Justin-Riekehof/zeroth-01-build/hardware/backpack_v2/viewer/viewer_template.html

X linksY hintenZ obenRoboter-Frame, mm

Z-Bot · Zeroth-01 · CAD-Pin 93de7567

# Pixel Backpack v2

Gesamter Roboter aus dem gepinnten OnShape-Stand mit dem neuen Elektronik-Rucksack. Ziehen dreht, Rad zoomt, rechte Taste verschiebt, Klick nennt das Teil.

## Ansicht

Iso Hinten Links Oben Vorn

## Teile

Roboter (Torso, Arme, Beine, Kopf)GLB Grundrahmen mit LiPo-SchubladeTeil 1 Elektronik-DeckTeil 2 RückdeckelTeil 3 Bauteil-Hüllen (LiPo, Pi, Cutoff …)Kontrolle Original-Backpack (K-Scale)105×24×80

Explosion0 mm Deckel-Deckkraft100 %

## Maße

Hüllkörper B × T × H

146 × 66,5 × 123 mm

Tiefe ab Rückwand (Y 38,1)

66,5 mm

Original K-Scale

105 × 24 × 80 mm

Höhe über Boden

Z 254 – 377

Breite

X ±73 (Torso)

Torso-Schrauben

4× M3, Ø4 Hülsen

Masse bestückt, geschätzt

≈ 750 g

Schwerpunkt hinter Rückwand

≈ 30 mm

Δ Schwerpunkt Roboter

+11 hinten · +10 oben

Arme schwingen laut Gelenkgrenzen nur nach vorn; Beine erreichen die Rückenzone unterhalb Z 252 erst ab Y 128. Details in hardware/backpack_v2/README.md.
