Justin-Riekehof/zeroth-01-build/hardware/backpack_v2/preview_iso.png

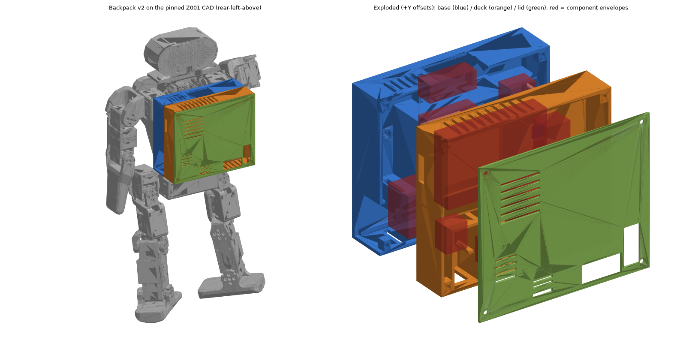
hardware/backpack_v2/preview_iso.png
