Justin-Riekehof/zeroth-01-build/media/whole-body-demo.gif

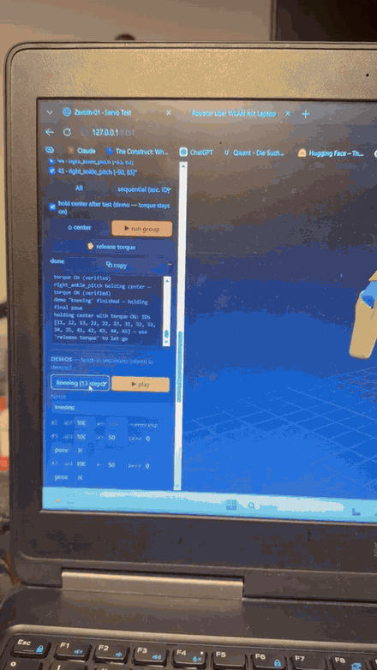
media/whole-body-demo.gif
