Justin-Riekehof/zeroth-01-build/hardware/backpack_v2/preview_v3_parts.png

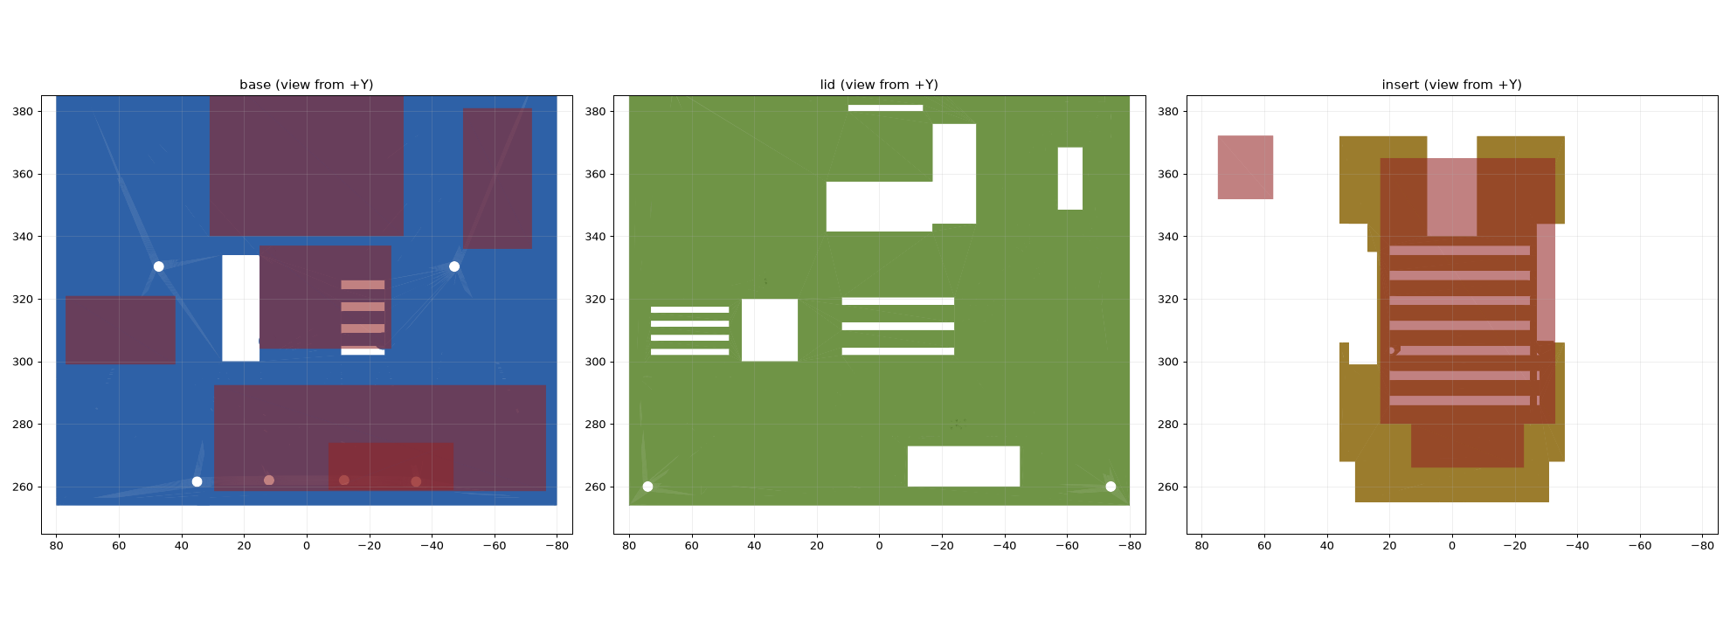
hardware/backpack_v2/preview_v3_parts.png
