Justin-Riekehof/zeroth-01-build/hardware/backpack_v2/print/pixel-backpack-v4_1-base.stl

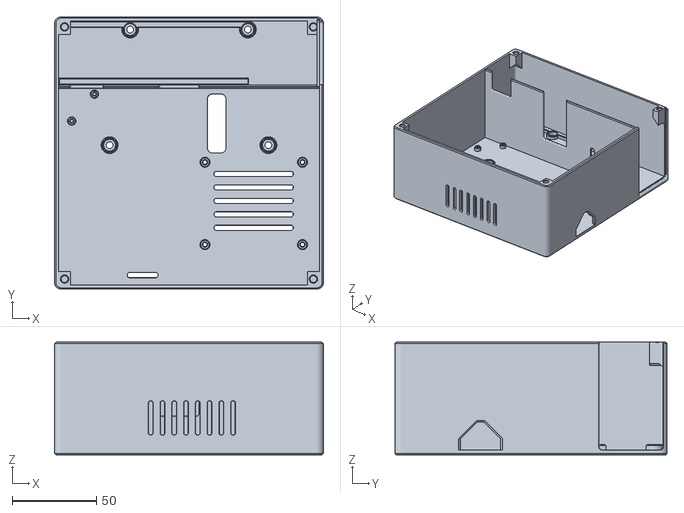
[picture p11: CAD file, 2026-10-01]
hardware/backpack_v2/print/pixel-backpack-v4_1-base.stl
160.0 x 162.0 x 67.0
