Justin-Riekehof/zeroth-01-build/hardware/backpack_v2/print/v3.1_scharfkantig/pixel-backpack-v3.1_1-base.stl

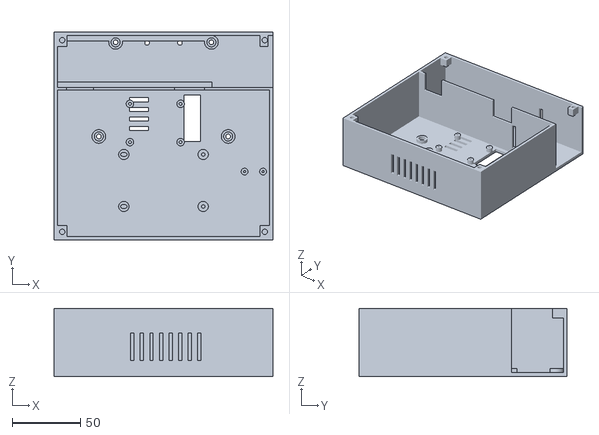
[picture p12: CAD file, 2026-09-22]
hardware/backpack_v2/print/v3.1_scharfkantig/pixel-backpack-v3.1_1-base.stl
160.0 x 152.0 x 50.0
