Justin-Riekehof/zeroth-01-build/hardware/backpack_v2/stl_v3/cables/pololu_5v_usbc.stl

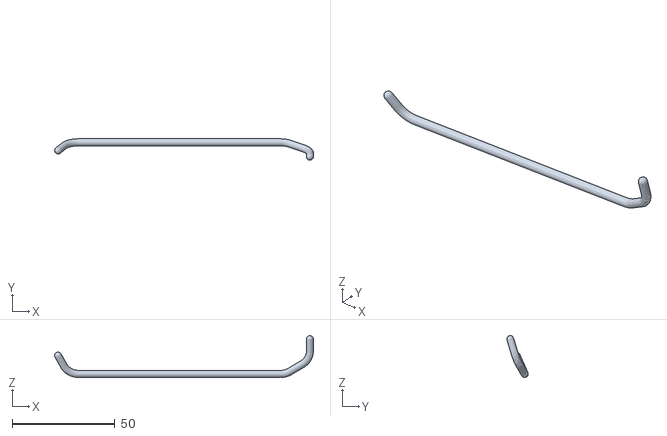
[picture p13: CAD file, 2026-10-01]
hardware/backpack_v2/stl_v3/cables/pololu_5v_usbc.stl
126.3 x 10.5 x 20.5
