Justin-Riekehof/zeroth-01-build/hardware/backpack_v2/stl_v3/placeholder_pi_plugs.stl

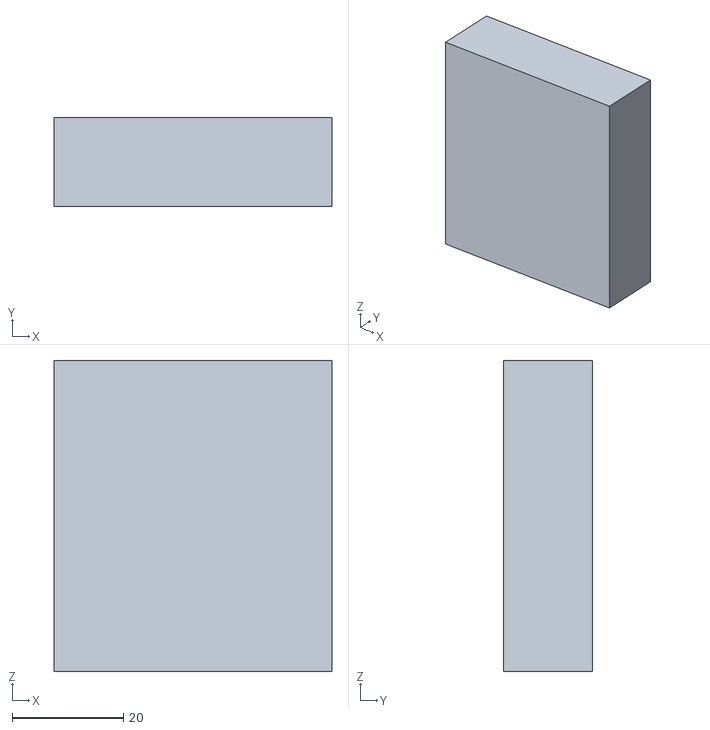
[picture p14: CAD file, 2026-10-01]
hardware/backpack_v2/stl_v3/placeholder_pi_plugs.stl
50.0 x 16.0 x 56.0
