Justin-Riekehof/zeroth-01-build/hardware/head_cam/print/head_shell_cam3.stl

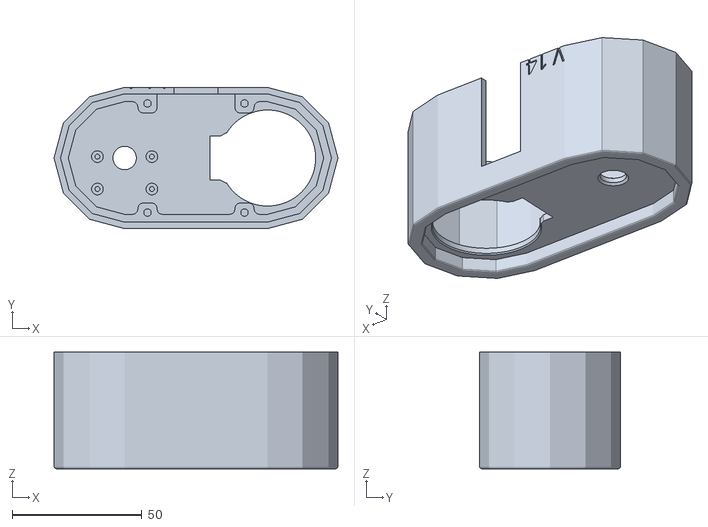
[picture p15: CAD file, 2026-09-22]
hardware/head_cam/print/head_shell_cam3.stl
109.5 x 54.5 x 45.0
