Justin-Riekehof/zeroth-01-build/hardware/head_cam/stl/robotframe/cam3_board.stl

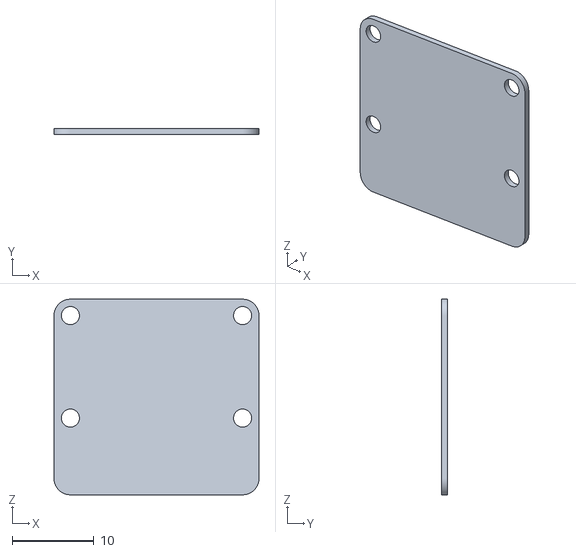
[picture p16: CAD file, 2026-09-22]
hardware/head_cam/stl/robotframe/cam3_board.stl
25.0 x 0.757 x 23.9
