Justin-Riekehof/zeroth-01-build/hardware/head_imu/print/neck_mount_imu.stl

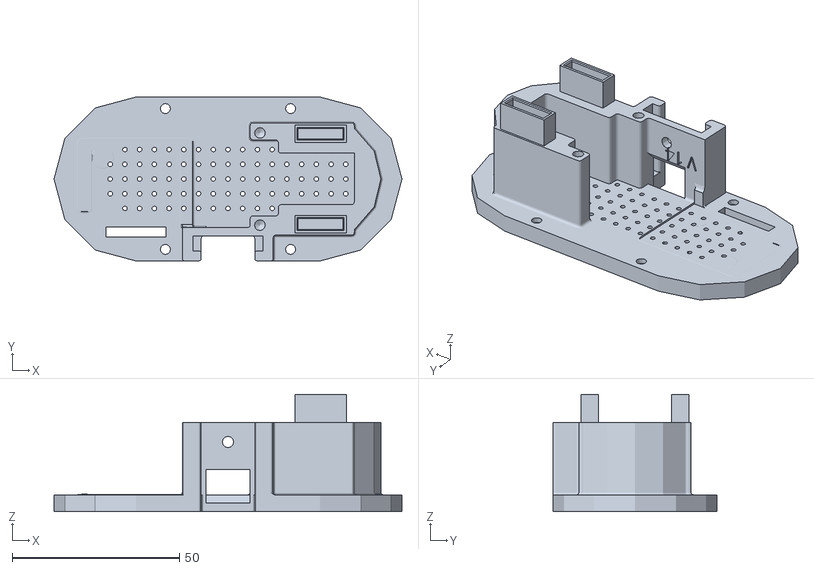
[picture p17: CAD file, 2026-10-01]
hardware/head_imu/print/neck_mount_imu.stl
104.0 x 49.0 x 35.0
