Justin-Riekehof/zeroth-01-build/hardware/head_imu/stl/imu_rp2040.stl

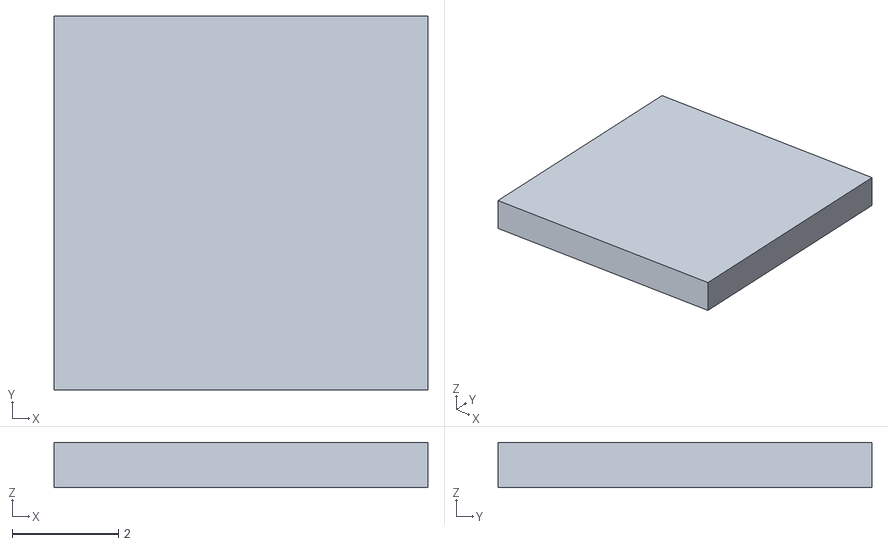
[picture p18: CAD file, 2026-09-22]
hardware/head_imu/stl/imu_rp2040.stl
7.04 x 7.04 x 0.85
