Justin-Riekehof/zeroth-01-build/sim/assets/zbot-cad/meshes/base_printed.stl

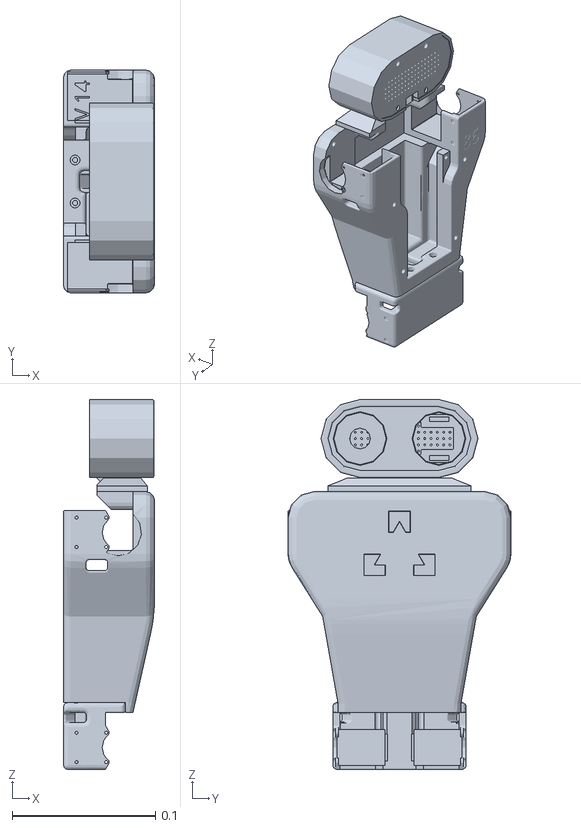
[picture p19: CAD file, 2026-09-26]
sim/assets/zbot-cad/meshes/base_printed.stl
0.0635 x 0.155 x 0.258
