Justin-Riekehof/zeroth-01-build/hardware/backpack_v2/print/pixel-backpack-v4_2-lid.stl

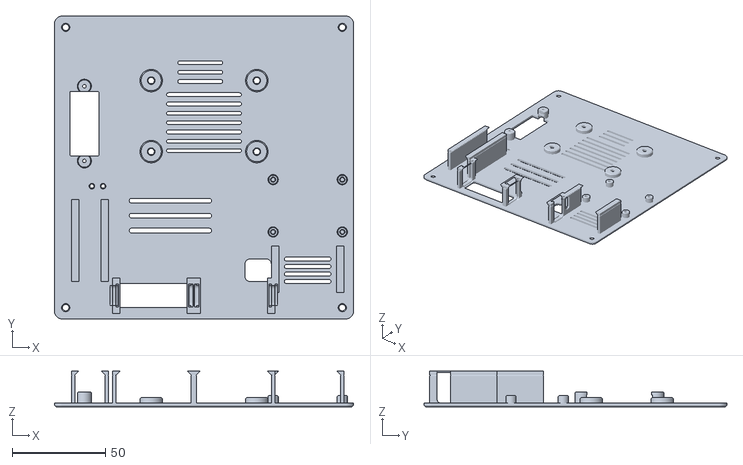
[picture p20: CAD file, 2026-10-01]
hardware/backpack_v2/print/pixel-backpack-v4_2-lid.stl
160.0 x 162.0 x 19.1
