Justin-Riekehof/zeroth-01-build/hardware/backpack_v2/print/v3.1_scharfkantig/pixel-backpack-v3.1_2-lid.stl

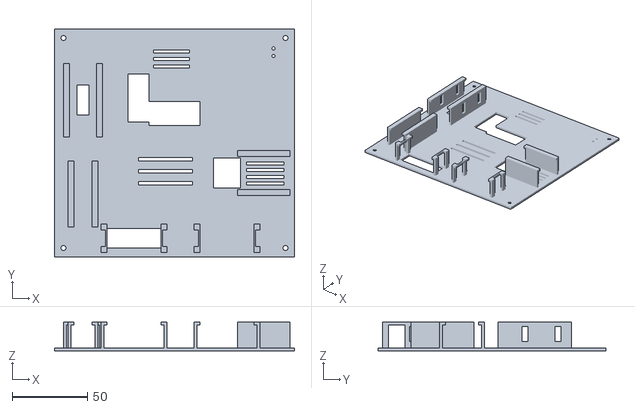
[picture p21: CAD file, 2026-09-22]
hardware/backpack_v2/print/v3.1_scharfkantig/pixel-backpack-v3.1_2-lid.stl
160.0 x 152.0 x 19.1
