Justin-Riekehof/zeroth-01-build/hardware/backpack_v2/stl_v3/cables/switch_out_pigtail.stl

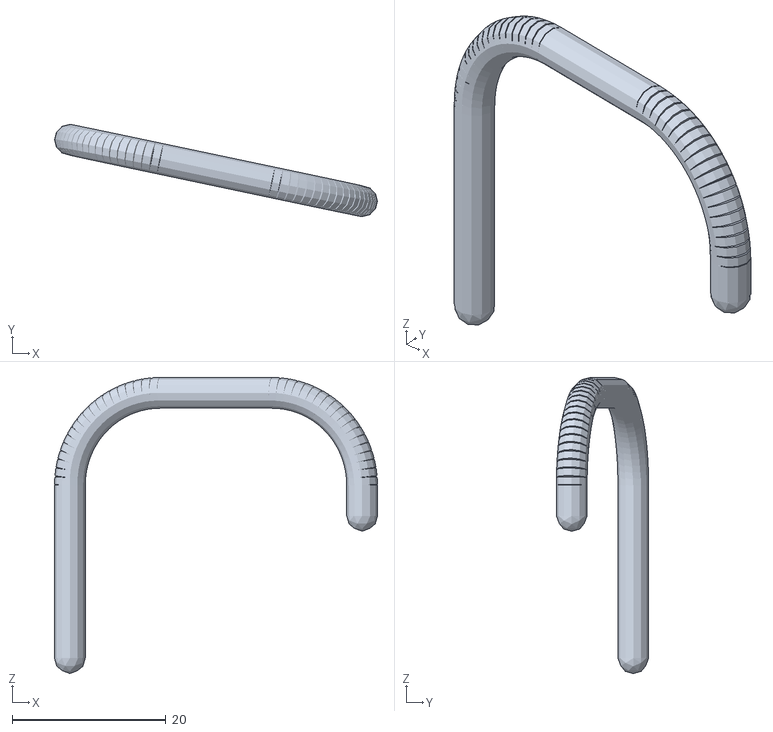
[picture p22: CAD file, 2026-10-01]
hardware/backpack_v2/stl_v3/cables/switch_out_pigtail.stl
42.0 x 12.0 x 38.5
