Justin-Riekehof/zeroth-01-build/hardware/backpack_v2/stl_v3/placeholder_pi_sd.stl

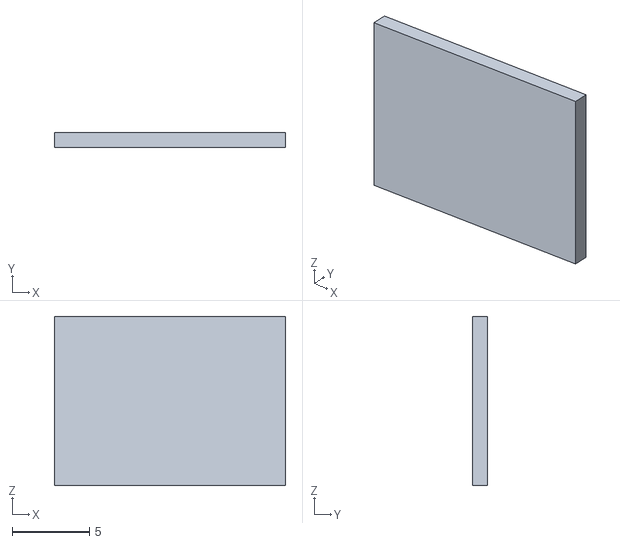
[picture p23: CAD file, 2026-10-01]
hardware/backpack_v2/stl_v3/placeholder_pi_sd.stl
15.0 x 1.00 x 11.0
