Justin-Riekehof/zeroth-01-build/hardware/head_imu/stl/imu_axis_x.stl

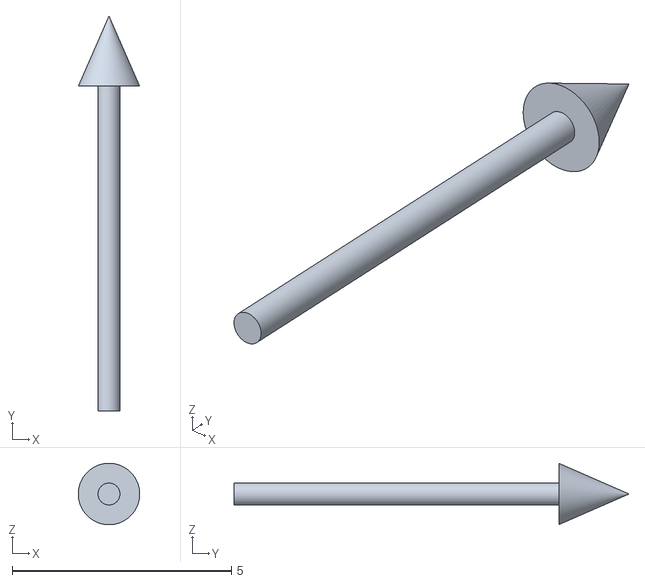
[picture p24: CAD file, 2026-09-22]
hardware/head_imu/stl/imu_axis_x.stl
1.40 x 9.00 x 1.40
