Justin-Riekehof/zeroth-01-build/sim/assets/zbot-cad/meshes/backpack_base.stl

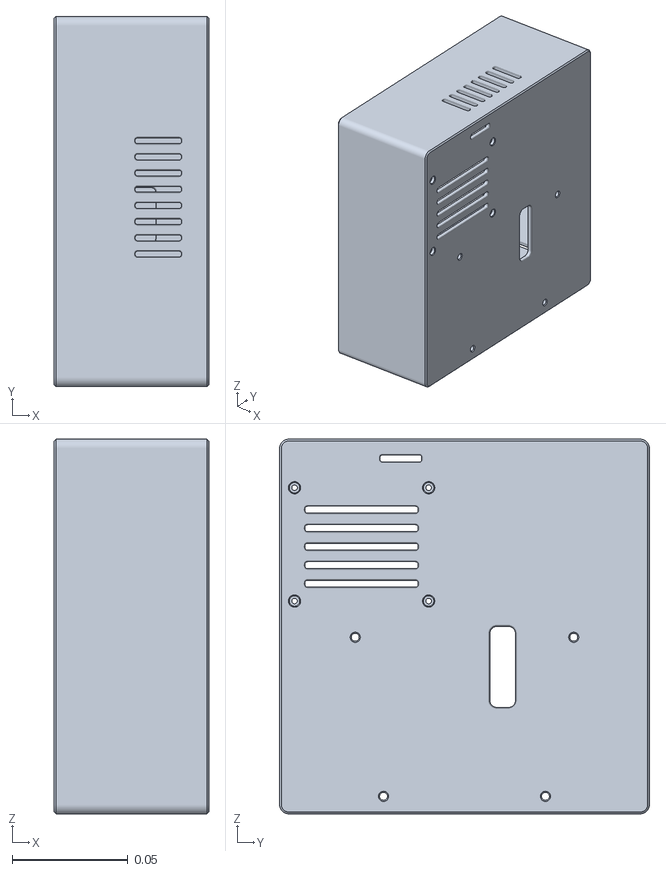
[picture p25: CAD file, 2026-09-26]
sim/assets/zbot-cad/meshes/backpack_base.stl
0.067 x 0.16 x 0.162
