Justin-Riekehof/zeroth-01-build/sim/assets/zbot-pixel-backpack/meshes/backpack_insert.stl

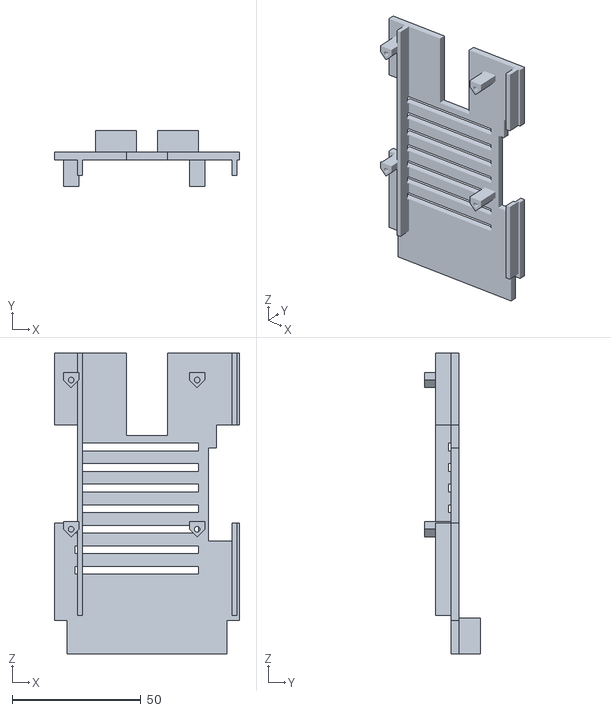
[picture p26: CAD file, 2026-09-22]
sim/assets/zbot-pixel-backpack/meshes/backpack_insert.stl
72.0 x 21.9 x 117.0
