Justin-Riekehof/zeroth-01-build/hardware/backpack_v2/stl_v3/cables/out_to_pololu.stl

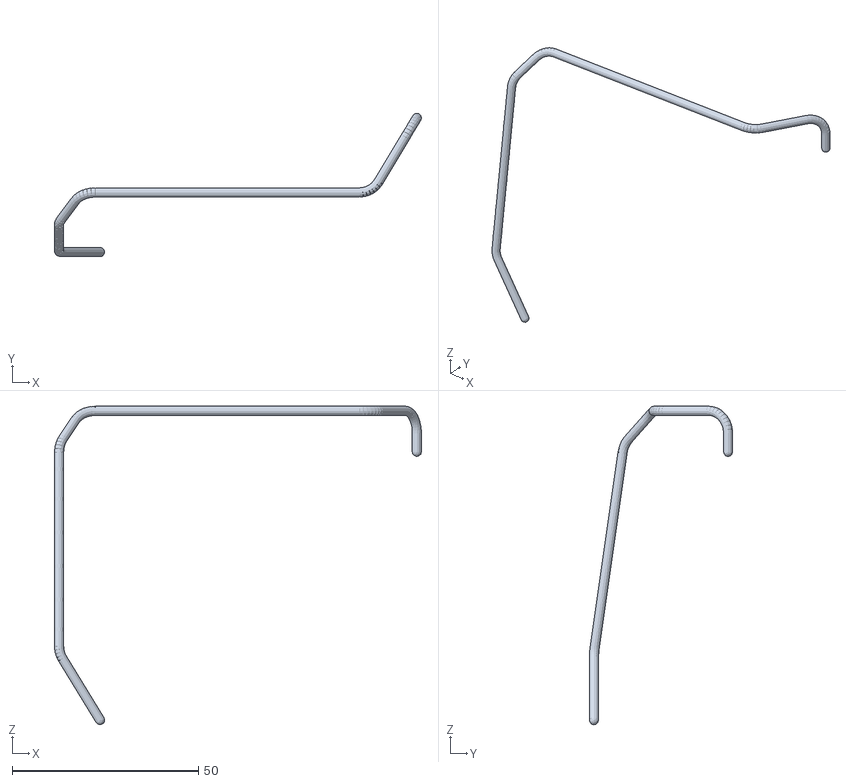
[picture p27: CAD file, 2026-10-01]
hardware/backpack_v2/stl_v3/cables/out_to_pololu.stl
98.5 x 38.5 x 85.5
