Justin-Riekehof/zeroth-01-build/hardware/backpack_v2/stl_v3/placeholder_pi.stl

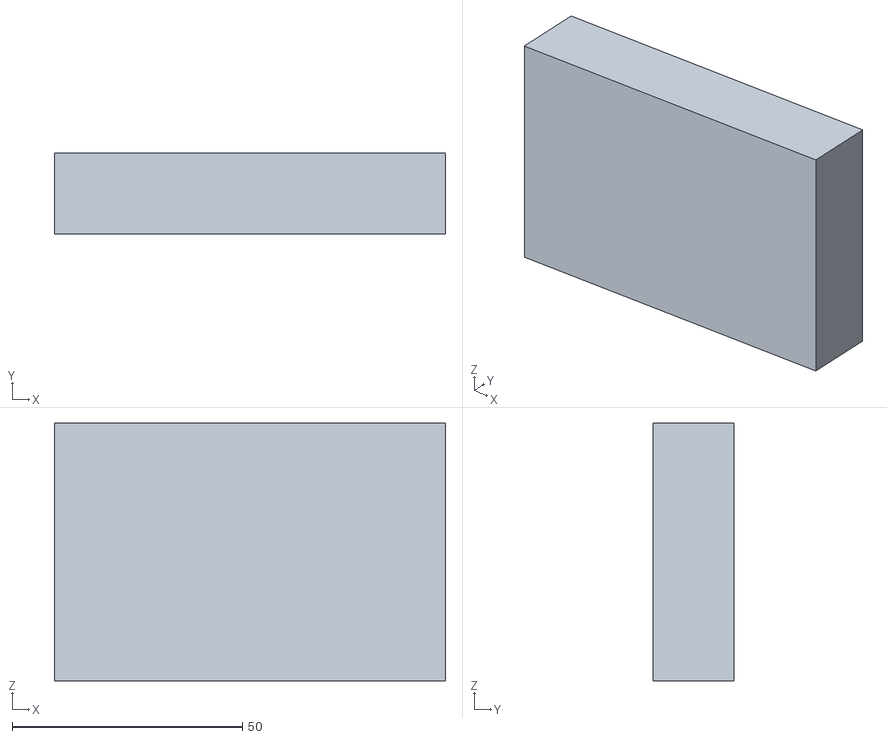
[picture p28: CAD file, 2026-10-01]
hardware/backpack_v2/stl_v3/placeholder_pi.stl
85.0 x 17.5 x 56.0
