Justin-Riekehof/zeroth-01-build/hardware/head_cam/stl/robotframe/cam3_module.stl

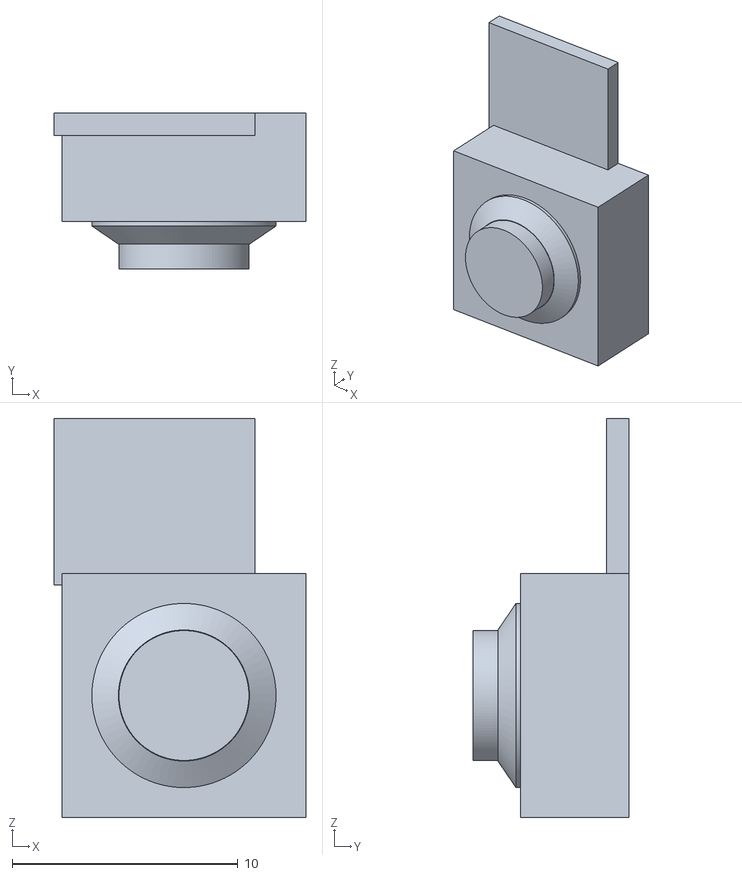
[picture p29: CAD file, 2026-09-22]
hardware/head_cam/stl/robotframe/cam3_module.stl
11.1 x 6.91 x 17.7
