Justin-Riekehof/zeroth-01-build/hardware/head_imu/stl/imu_adapter_h1.stl

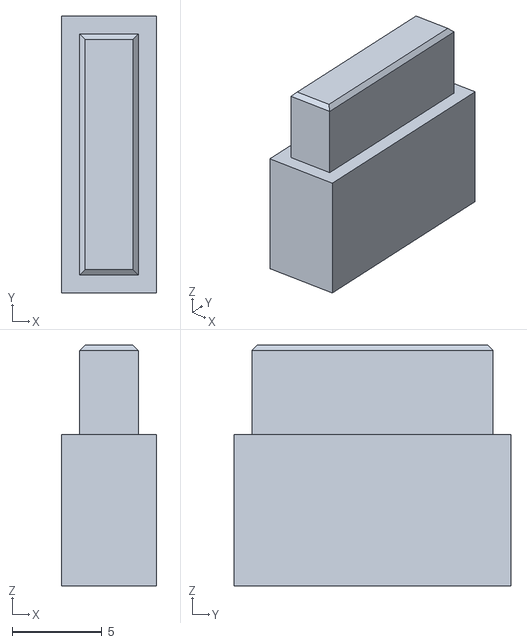
[picture p30: CAD file, 2026-09-22]
hardware/head_imu/stl/imu_adapter_h1.stl
5.27 x 15.4 x 13.4
