Justin-Riekehof/zeroth-01-build/sim/assets/zbot-cad/meshes/backpack_lid.stl

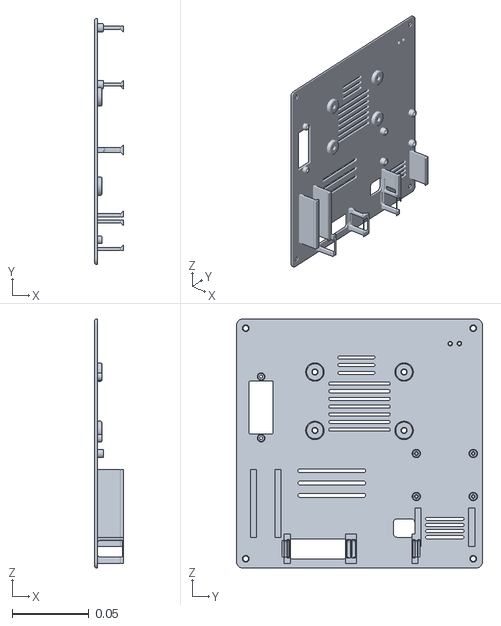
[picture p31: CAD file, 2026-09-26]
sim/assets/zbot-cad/meshes/backpack_lid.stl
0.0191 x 0.16 x 0.162
