Justin-Riekehof/zeroth-01-build/hardware/backpack_v2/stl_v3/cables/test_leads_5v.stl

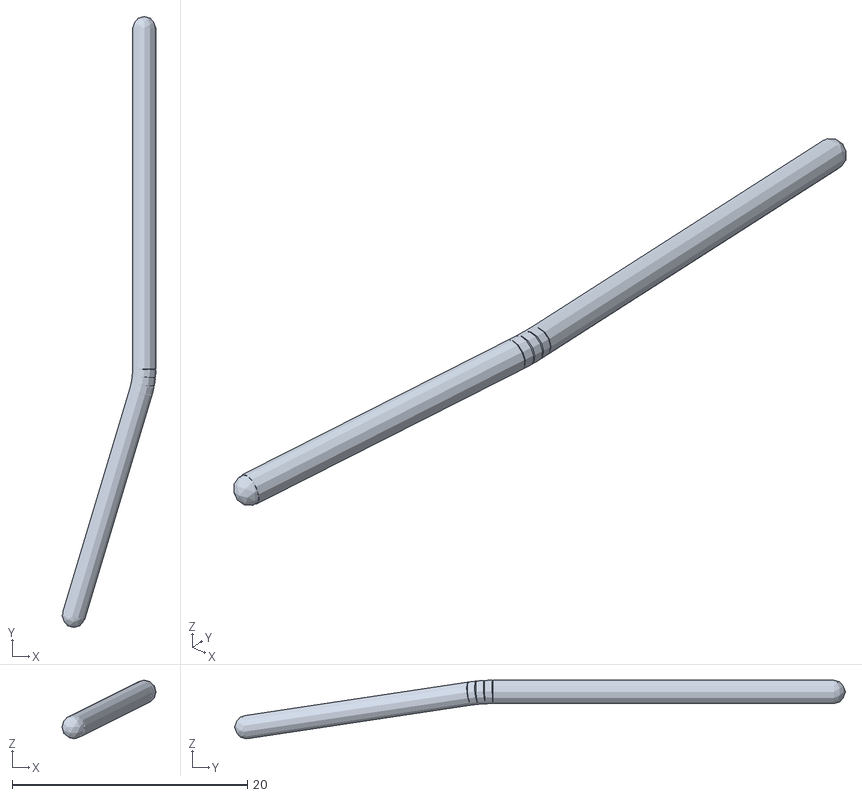
[picture p32: CAD file, 2026-10-01]
hardware/backpack_v2/stl_v3/cables/test_leads_5v.stl
8.00 x 52.0 x 5.00
