Justin-Riekehof/zeroth-01-build/hardware/backpack_v2/stl_v3/placeholder_pololu.stl

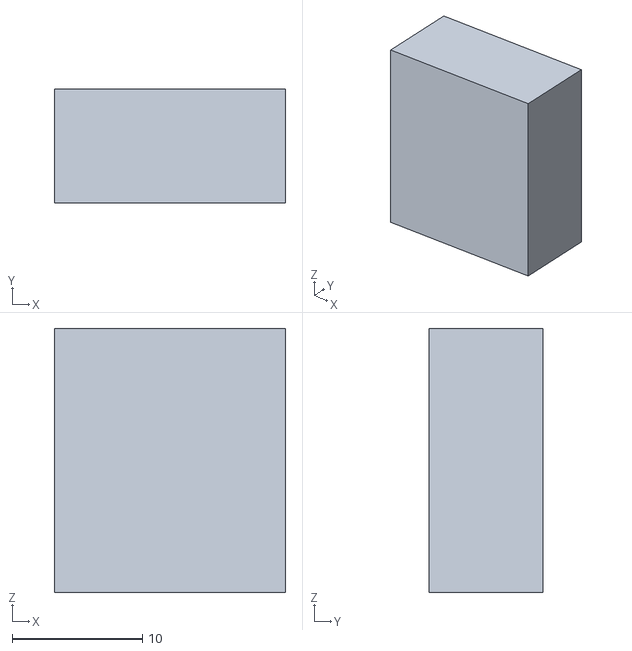
[picture p33: CAD file, 2026-10-01]
hardware/backpack_v2/stl_v3/placeholder_pololu.stl
17.8 x 8.80 x 20.3
