Justin-Riekehof/zeroth-01-build/hardware/head_cam/stl/robotframe/cam3_j1.stl

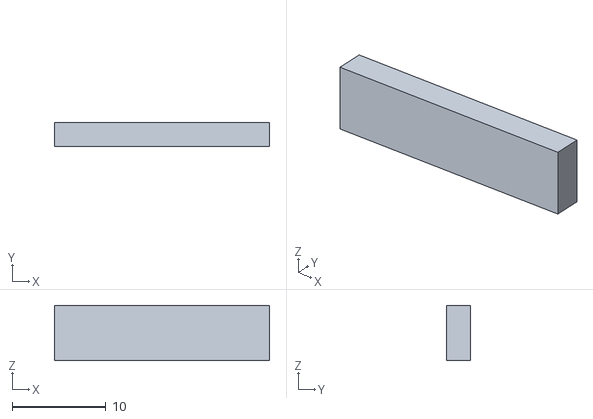
[picture p34: CAD file, 2026-09-22]
hardware/head_cam/stl/robotframe/cam3_j1.stl
22.9 x 2.58 x 5.91
