Justin-Riekehof/zeroth-01-build/hardware/head_imu/stl/robotframe/imu_sw_boot.stl

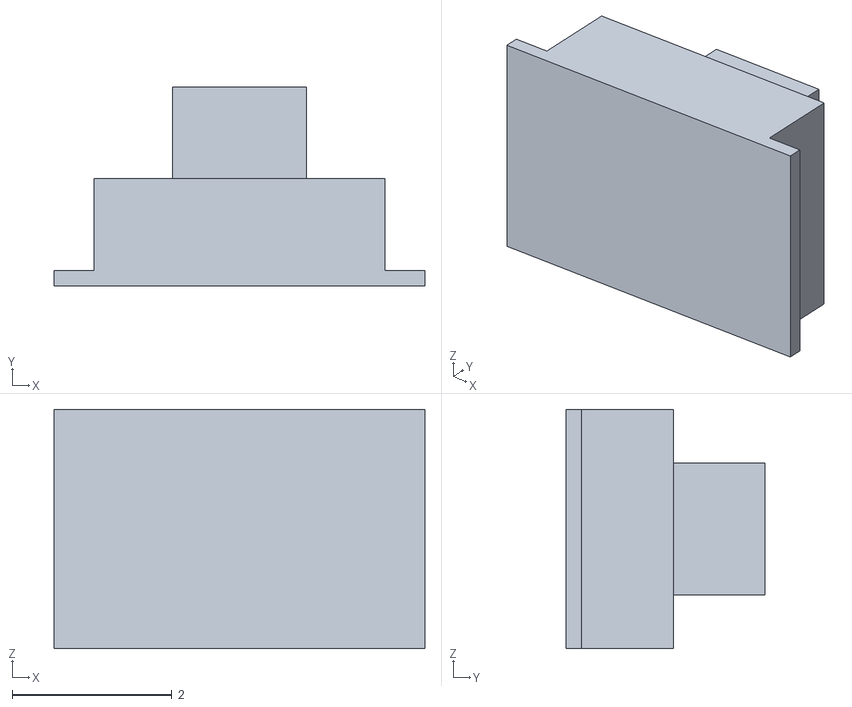
[picture p35: CAD file, 2026-09-22]
hardware/head_imu/stl/robotframe/imu_sw_boot.stl
4.65 x 2.50 x 3.00
