Justin-Riekehof/zeroth-01-build/sim/assets/zbot-cad/meshes/right_hip_yaw_link_printed.stl

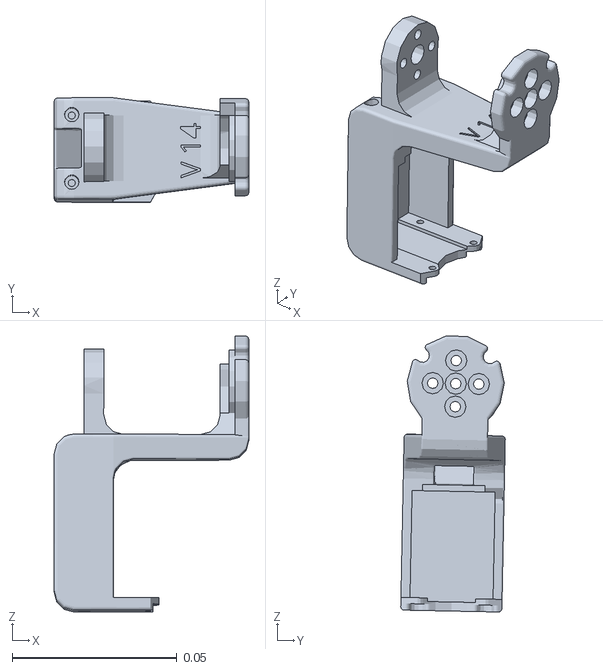
[picture p36: CAD file, 2026-09-22]
sim/assets/zbot-cad/meshes/right_hip_yaw_link_printed.stl
0.0591 x 0.0317 x 0.0838
