Justin-Riekehof/zeroth-01-build/sim/assets/zbot-pixel-backpack/meshes/U_HIP_L.stl

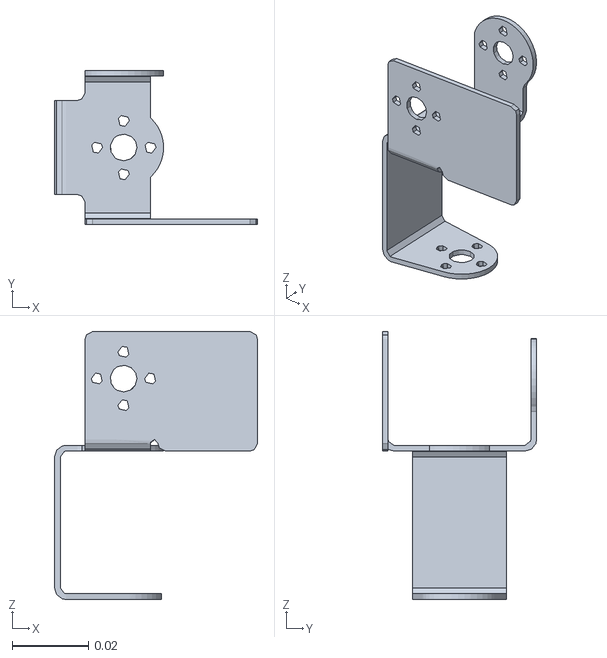
[picture p37: CAD file, 2026-08-21]
sim/assets/zbot-pixel-backpack/meshes/U_HIP_L.stl
0.0532 x 0.0404 x 0.0703
