Justin-Riekehof/zeroth-01-build/hardware/backpack_v2/stl_v3/cables/servo_bus_a.stl

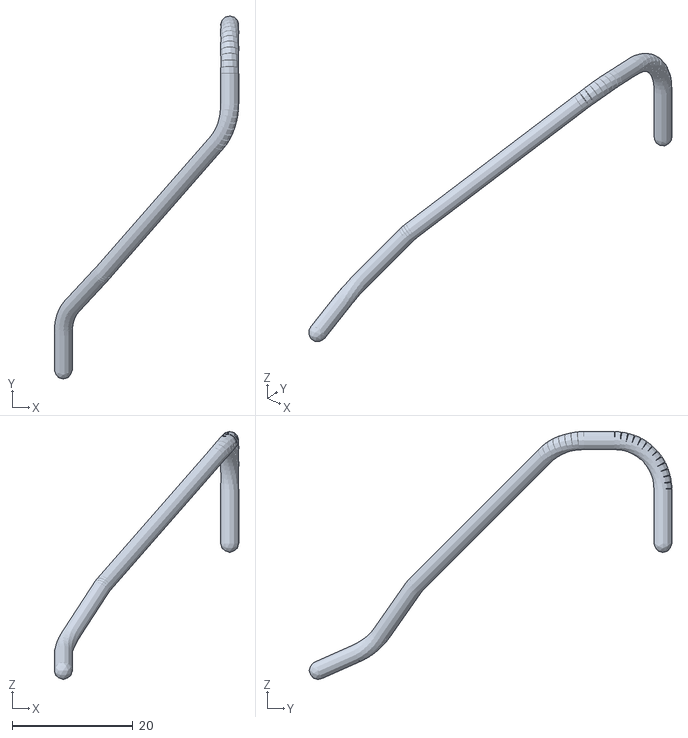
[picture p38: CAD file, 2026-10-01]
hardware/backpack_v2/stl_v3/cables/servo_bus_a.stl
30.5 x 60.0 x 41.0
