Justin-Riekehof/zeroth-01-build/hardware/backpack_v2/stl_v3/placeholder_pololu_wires.stl

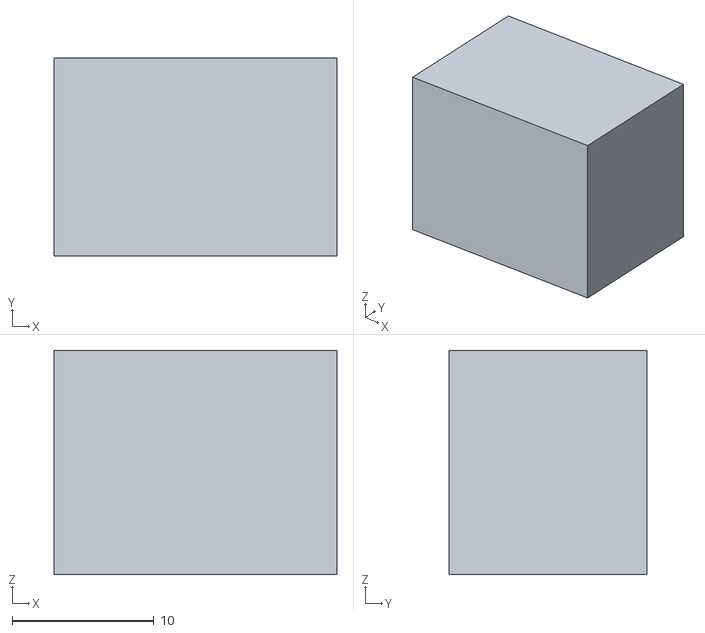
[picture p39: CAD file, 2026-10-01]
hardware/backpack_v2/stl_v3/placeholder_pololu_wires.stl
20.0 x 14.0 x 15.9
