Justin-Riekehof/zeroth-01-build/hardware/head_cam/stl/robotframe/cam3_fpc.stl

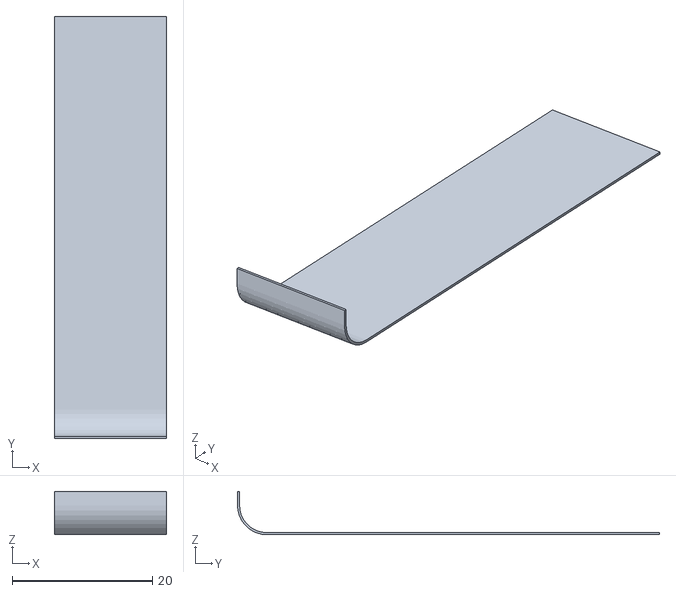
[picture p40: CAD file, 2026-09-22]
hardware/head_cam/stl/robotframe/cam3_fpc.stl
16.0 x 60.1 x 6.18
