Justin-Riekehof/zeroth-01-build/hardware/head_imu/stl/robotframe/imu_hdr_h2.stl

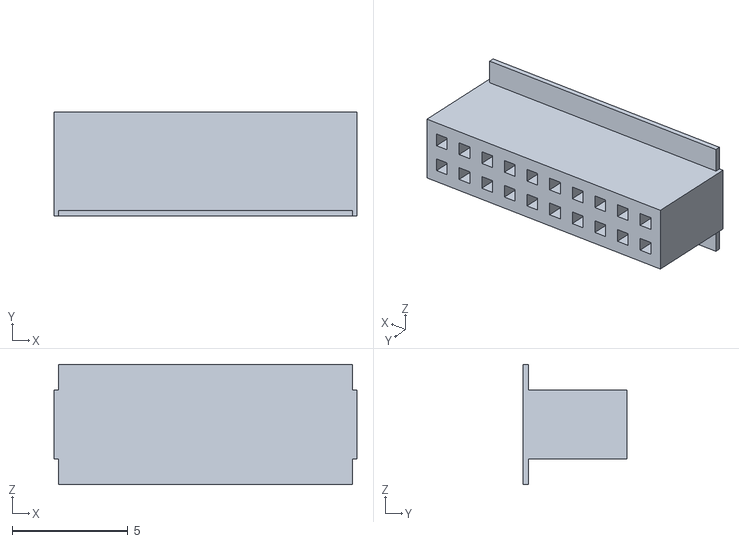
[picture p41: CAD file, 2026-09-22]
hardware/head_imu/stl/robotframe/imu_hdr_h2.stl
13.1 x 4.50 x 5.20
