Justin-Riekehof/zeroth-01-build/sim/assets/zbot-cad/meshes/base_servos.stl

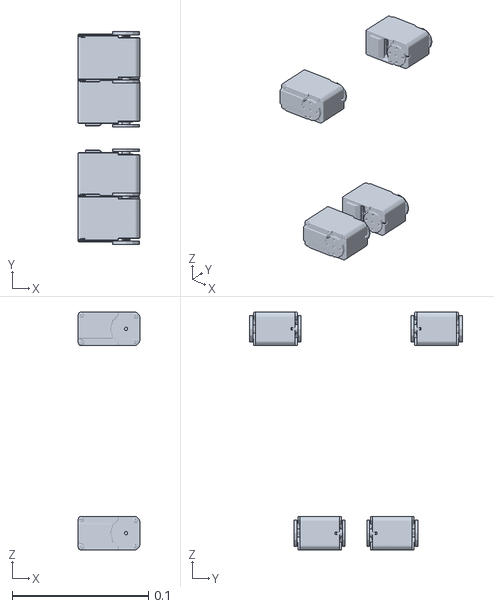
[picture p42: CAD file, 2026-09-22]
sim/assets/zbot-cad/meshes/base_servos.stl
0.0452 x 0.156 x 0.175
