Justin-Riekehof/zeroth-01-build/sim/assets/zbot-pixel-backpack/meshes/3215_1Flange.stl

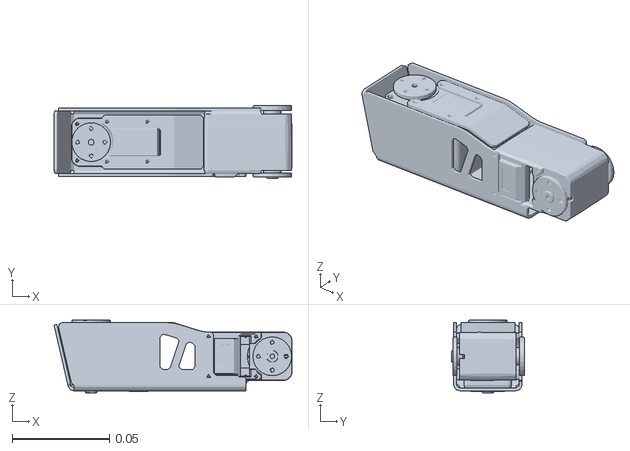
[picture p43: CAD file, 2026-08-21]
sim/assets/zbot-pixel-backpack/meshes/3215_1Flange.stl
0.122 x 0.0374 x 0.0374
