Justin-Riekehof/zeroth-01-build/hardware/backpack_v2/stl_v3/cables/servo_bus_b.stl

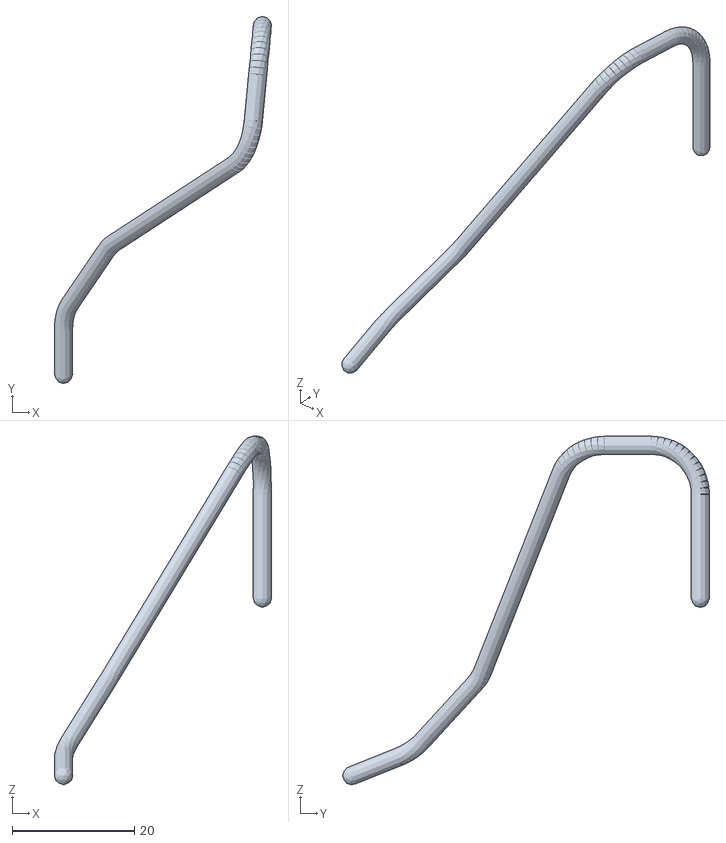
[picture p44: CAD file, 2026-10-01]
hardware/backpack_v2/stl_v3/cables/servo_bus_b.stl
35.5 x 60.0 x 57.0
