Justin-Riekehof/zeroth-01-build/hardware/head_cam/stl/robotframe/cam3_fov.stl

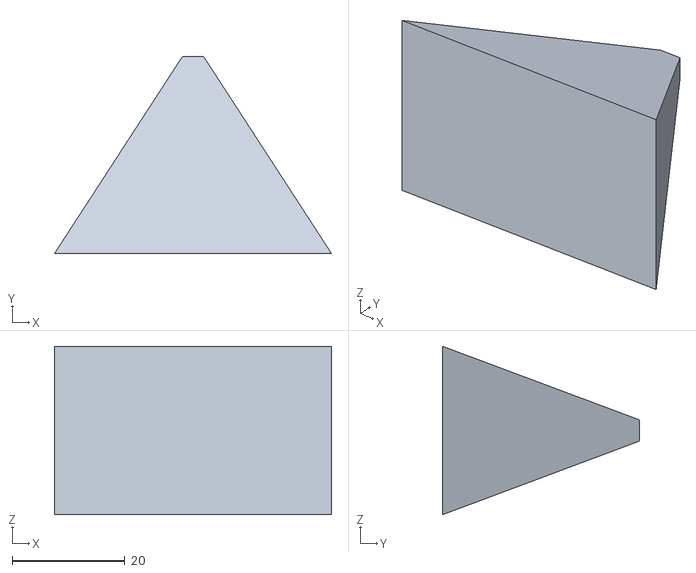
[picture p45: CAD file, 2026-09-22]
hardware/head_cam/stl/robotframe/cam3_fov.stl
49.2 x 35.0 x 29.9
