Justin-Riekehof/zeroth-01-build/sim/assets/zbot-cad/meshes/right_hip_pitch_link_printed.stl

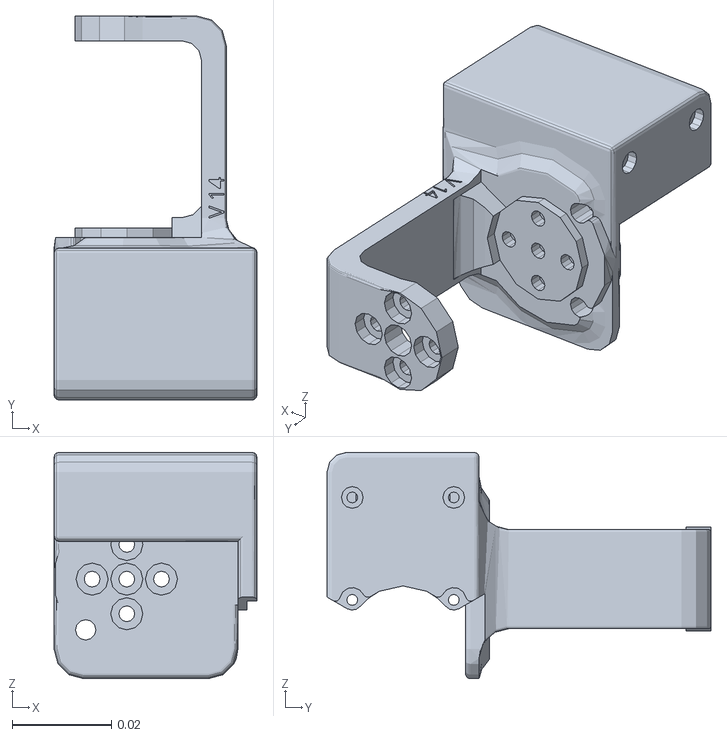
[picture p46: CAD file, 2026-09-22]
sim/assets/zbot-cad/meshes/right_hip_pitch_link_printed.stl
0.041 x 0.0776 x 0.0457
