Justin-Riekehof/zeroth-01-build/sim/assets/zbot-pixel-backpack/meshes/FOOT.stl

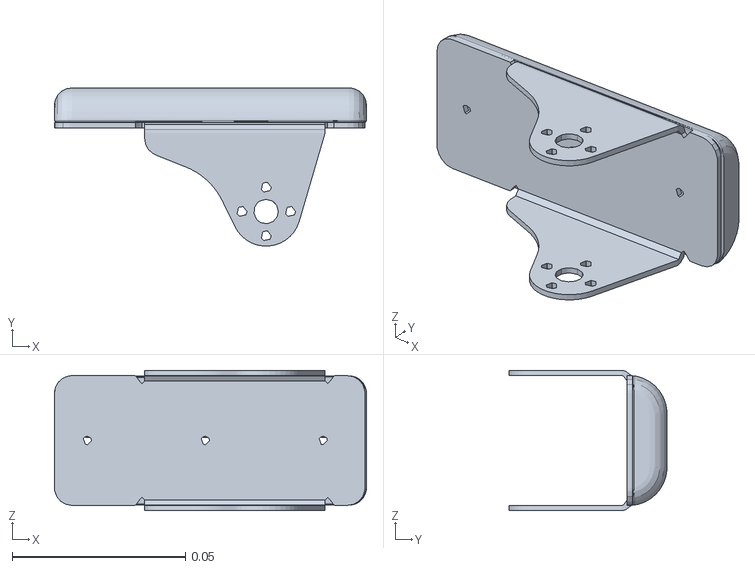
[picture p47: CAD file, 2026-08-21]
sim/assets/zbot-pixel-backpack/meshes/FOOT.stl
0.09 x 0.0456 x 0.0404
