Justin-Riekehof/zeroth-01-build/hardware/backpack_v2/stl_v3/cables/lipo_xt60_lead.stl

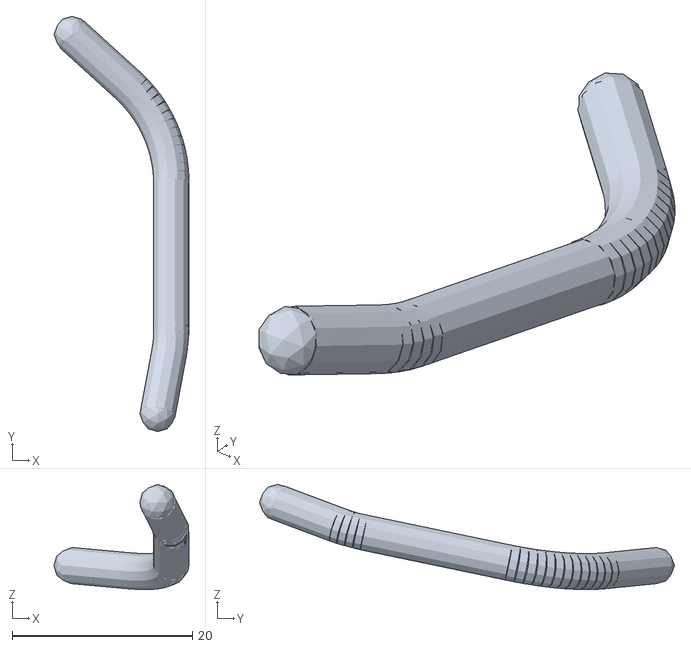
[picture p48: CAD file, 2026-10-01]
hardware/backpack_v2/stl_v3/cables/lipo_xt60_lead.stl
15.0 x 46.0 x 11.7
