Justin-Riekehof/zeroth-01-build/hardware/backpack_v2/stl_v3/placeholder_pi_usbc_plug.stl

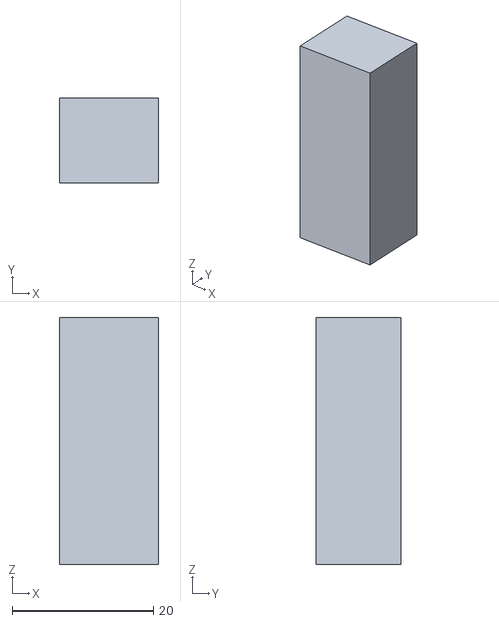
[picture p49: CAD file, 2026-10-01]
hardware/backpack_v2/stl_v3/placeholder_pi_usbc_plug.stl
14.0 x 12.0 x 35.0
