Justin-Riekehof/zeroth-01-build/hardware/head_imu/stl/imu_xtal.stl

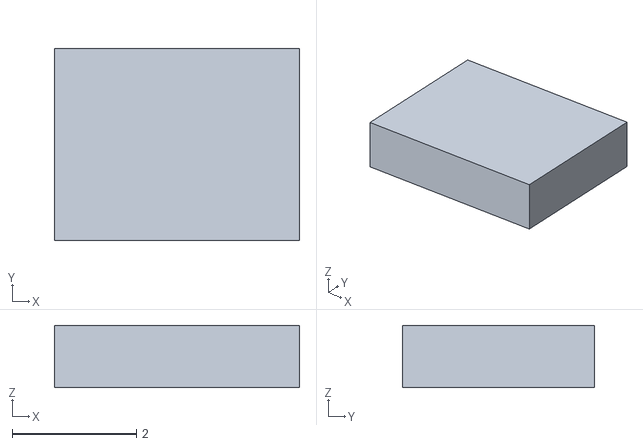
[picture p50: CAD file, 2026-09-22]
hardware/head_imu/stl/imu_xtal.stl
3.95 x 3.10 x 1.00
