Justin-Riekehof/zeroth-01-build/sim/assets/zbot-cad/meshes/right_knee_pitch_link_printed.stl

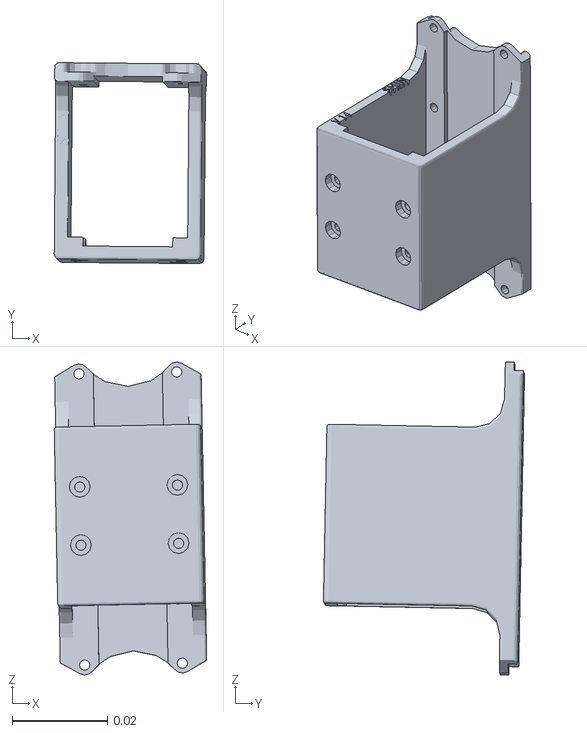
[picture p51: CAD file, 2026-09-22]
sim/assets/zbot-cad/meshes/right_knee_pitch_link_printed.stl
0.032 x 0.0422 x 0.0657
