Justin-Riekehof/zeroth-01-build/hardware/backpack_v2/stl_v3/cables/fuse_leg_2.stl

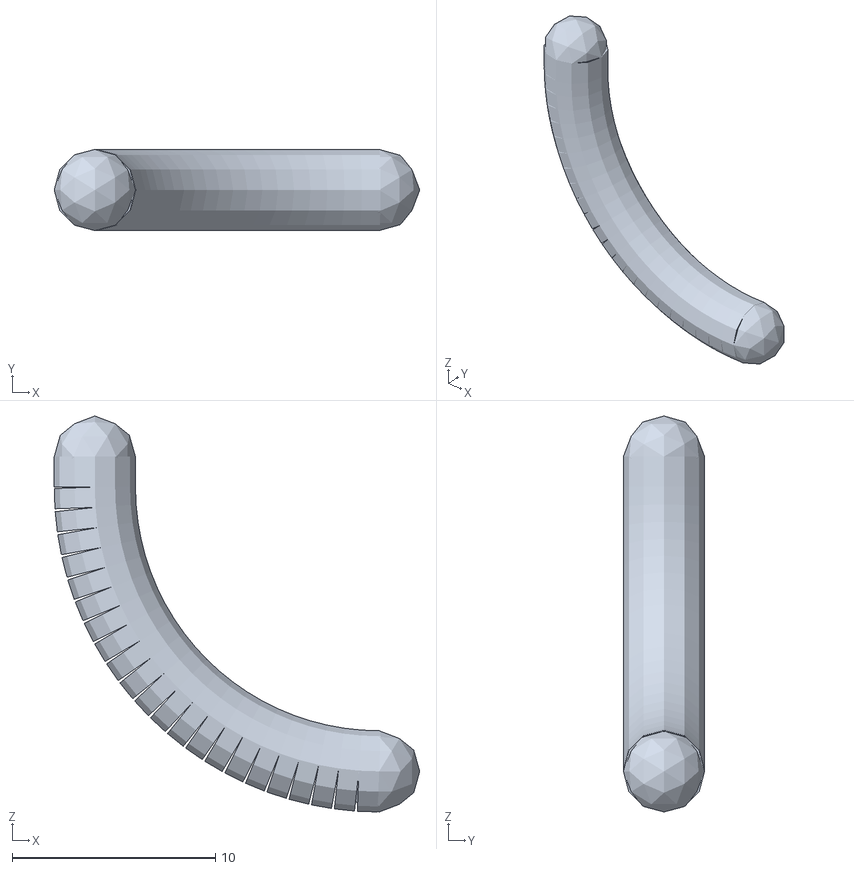
[picture p52: CAD file, 2026-10-01]
hardware/backpack_v2/stl_v3/cables/fuse_leg_2.stl
18.0 x 4.00 x 19.5
