Justin-Riekehof/zeroth-01-build/hardware/backpack_v2/stl_v3/placeholder_cam_ribbon.stl

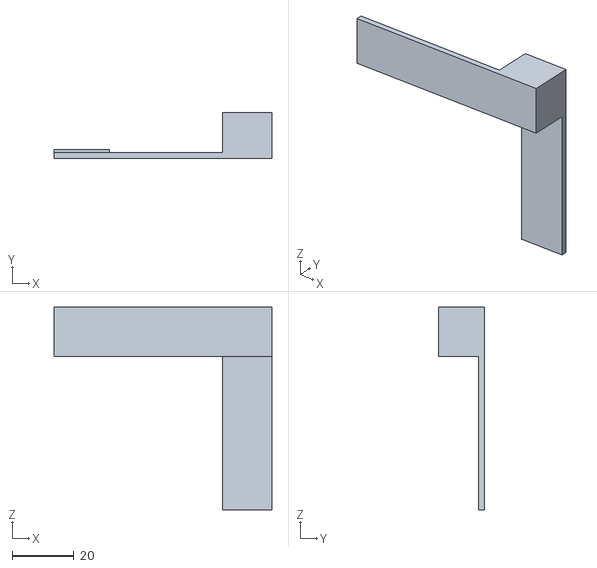
[picture p53: CAD file, 2026-10-01]
hardware/backpack_v2/stl_v3/placeholder_cam_ribbon.stl
70.5 x 15.0 x 65.5
