Justin-Riekehof/zeroth-01-build/hardware/head_imu/stl/robotframe/imu_xtal.stl

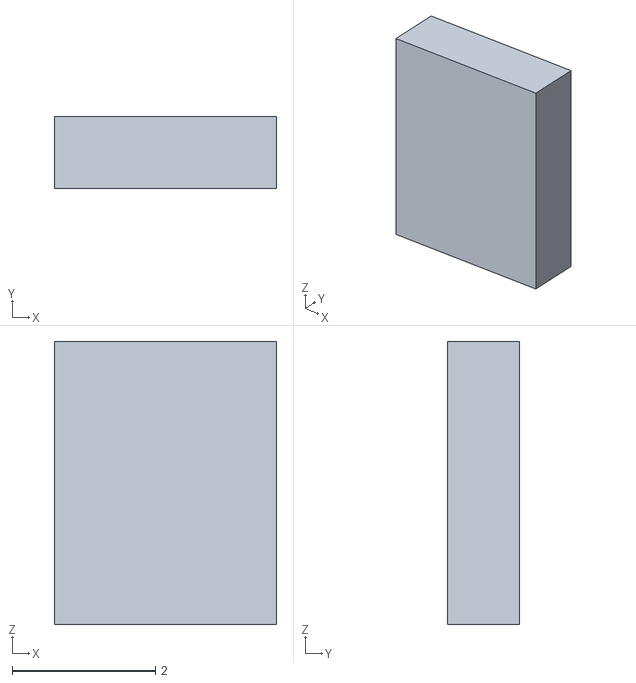
[picture p54: CAD file, 2026-09-22]
hardware/head_imu/stl/robotframe/imu_xtal.stl
3.10 x 1.00 x 3.95
