Justin-Riekehof/zeroth-01-build/sim/assets/zbot-cad/meshes/left_shoulder_pitch_link_printed.stl

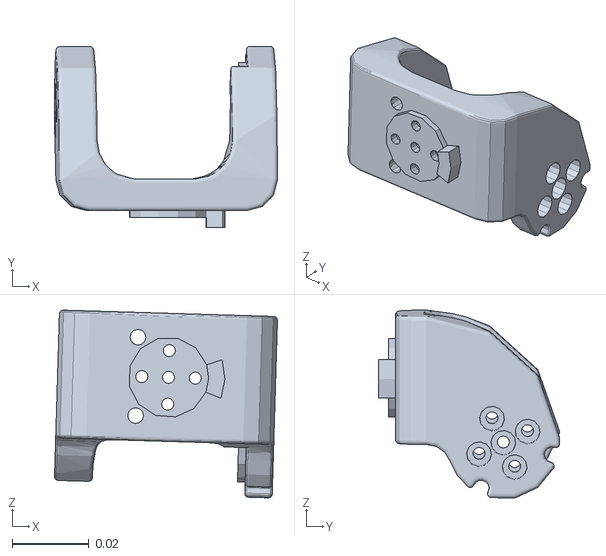
[picture p55: CAD file, 2026-09-22]
sim/assets/zbot-cad/meshes/left_shoulder_pitch_link_printed.stl
0.0583 x 0.0474 x 0.0491
