Justin-Riekehof/zeroth-01-build/sim/assets/zbot-pixel-backpack/meshes/FOOT_2.collision.stl

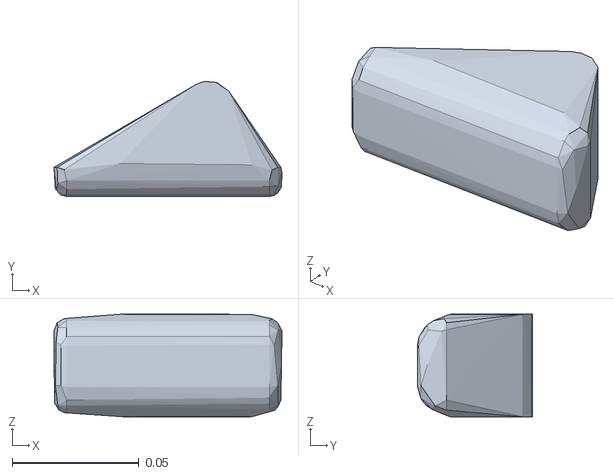
[picture p56: CAD file, 2026-08-21]
sim/assets/zbot-pixel-backpack/meshes/FOOT_2.collision.stl
0.09 x 0.0454 x 0.0404
