Justin-Riekehof/zeroth-01-build/hardware/backpack_v2/stl_v3/cables/pi_usb_to_waveshare.stl

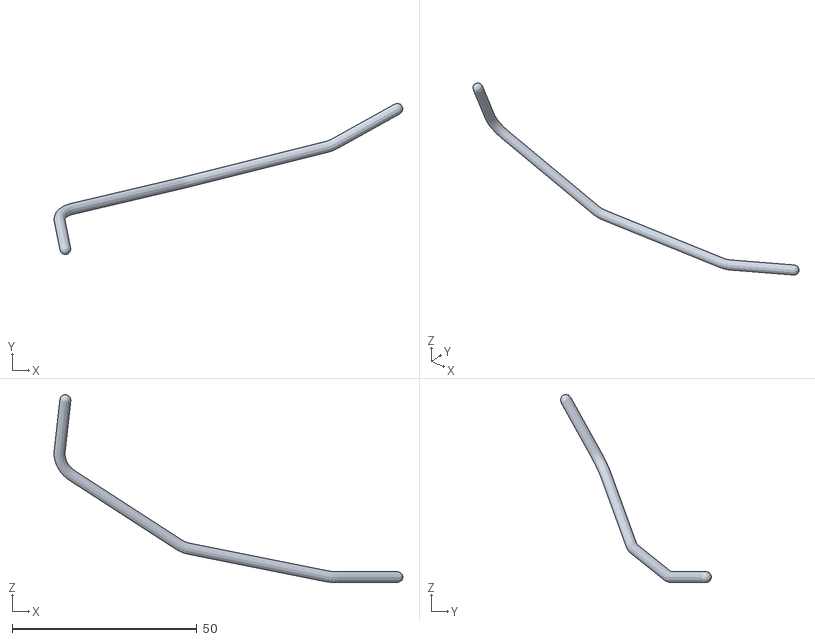
[picture p57: CAD file, 2026-10-01]
hardware/backpack_v2/stl_v3/cables/pi_usb_to_waveshare.stl
94.6 x 41.0 x 51.0
