Justin-Riekehof/zeroth-01-build/hardware/head_imu/stl/imu_pcb.stl

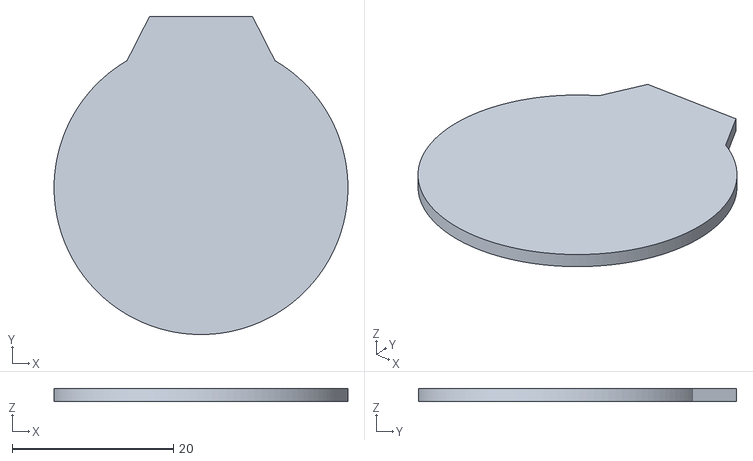
[picture p58: CAD file, 2026-09-22]
hardware/head_imu/stl/imu_pcb.stl
36.5 x 39.5 x 1.60
