Justin-Riekehof/zeroth-01-build/sim/assets/zbot-cad/meshes/left_hip_pitch_link_servos.stl

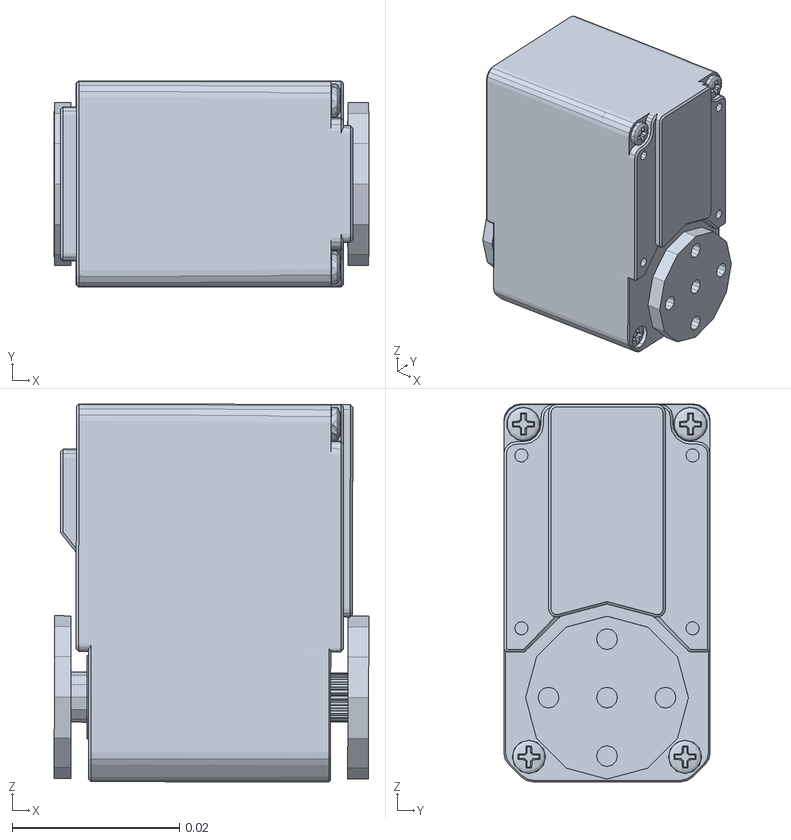
[picture p59: CAD file, 2026-09-22]
sim/assets/zbot-cad/meshes/left_hip_pitch_link_servos.stl
0.0377 x 0.0247 x 0.0453
