Justin-Riekehof/zeroth-01-build/hardware/backpack_v2/stl_v3/cables/out_to_waveshare.stl

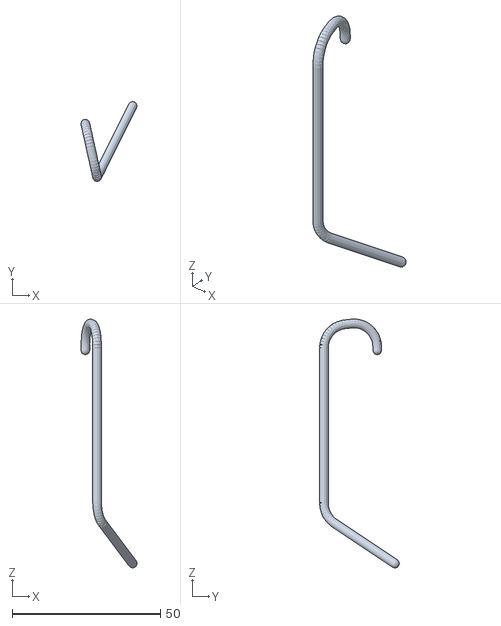
[picture p60: CAD file, 2026-09-22]
hardware/backpack_v2/stl_v3/cables/out_to_waveshare.stl
19.0 x 27.0 x 84.1
