Justin-Riekehof/zeroth-01-build/hardware/backpack_v2/stl_v3/placeholder_switch_bosses.stl

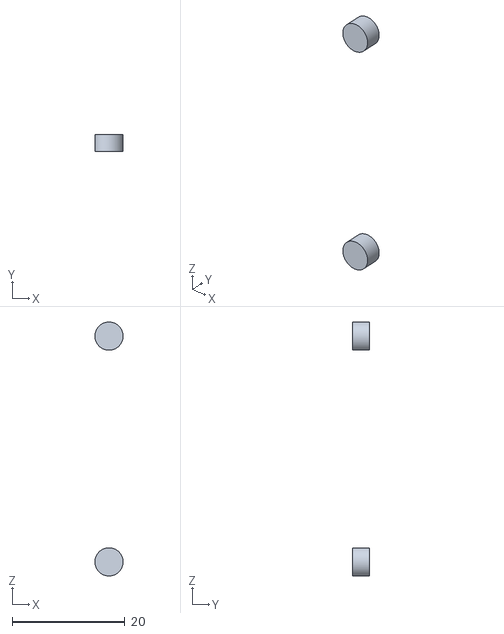
[picture p61: CAD file, 2026-10-01]
hardware/backpack_v2/stl_v3/placeholder_switch_bosses.stl
5.00 x 3.00 x 45.0
