Justin-Riekehof/zeroth-01-build/hardware/head_imu/stl/robotframe/imu_l1.stl

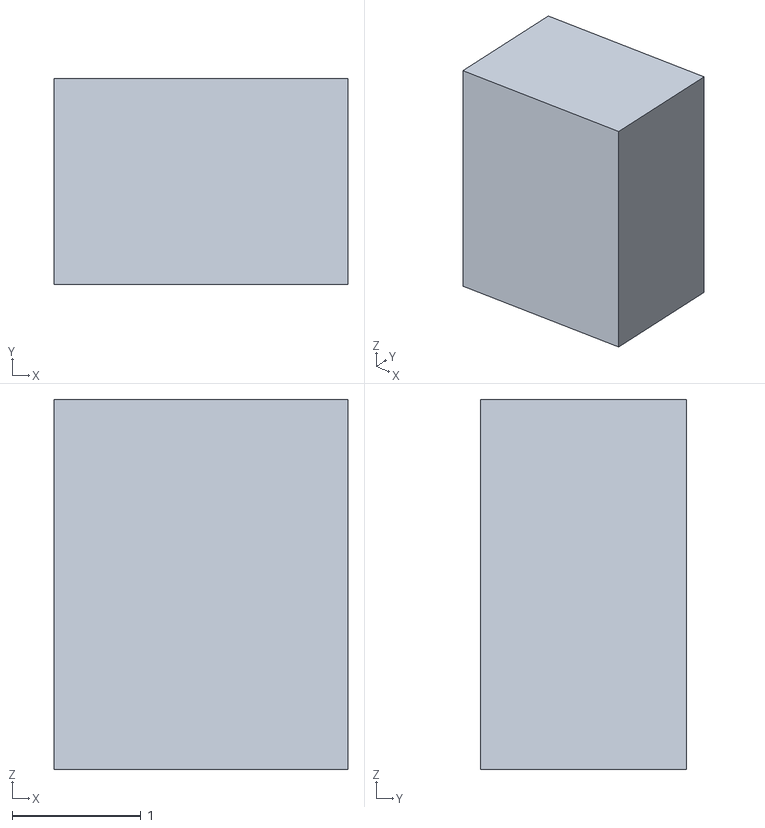
[picture p62: CAD file, 2026-09-22]
hardware/head_imu/stl/robotframe/imu_l1.stl
2.28 x 1.60 x 2.87
