Justin-Riekehof/zeroth-01-build/hardware/head_imu/stl/rp2040_lcd_128.step

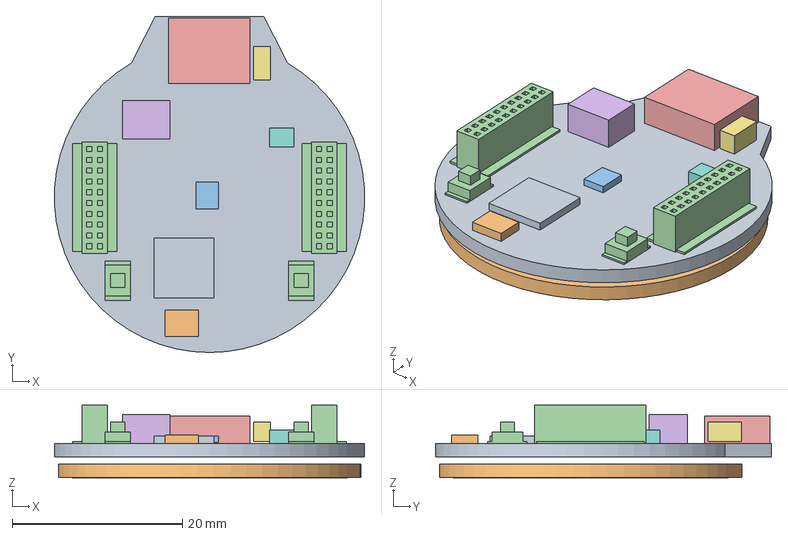
[picture p63: CAD file, 2026-09-22]
hardware/head_imu/stl/rp2040_lcd_128.step
36.5 x 39.5 x 8.55 mm
pcb
lcd_panel
lcd_viewarea
hdr_h1
hdr_h2
usbc
batt
d1
l1
rp2040
xtal
qmi8658
sw_boot
sw_reset
