Justin-Riekehof/zeroth-01-build/sim/assets/zbot-cad/meshes/right_hip_roll_link_printed.stl

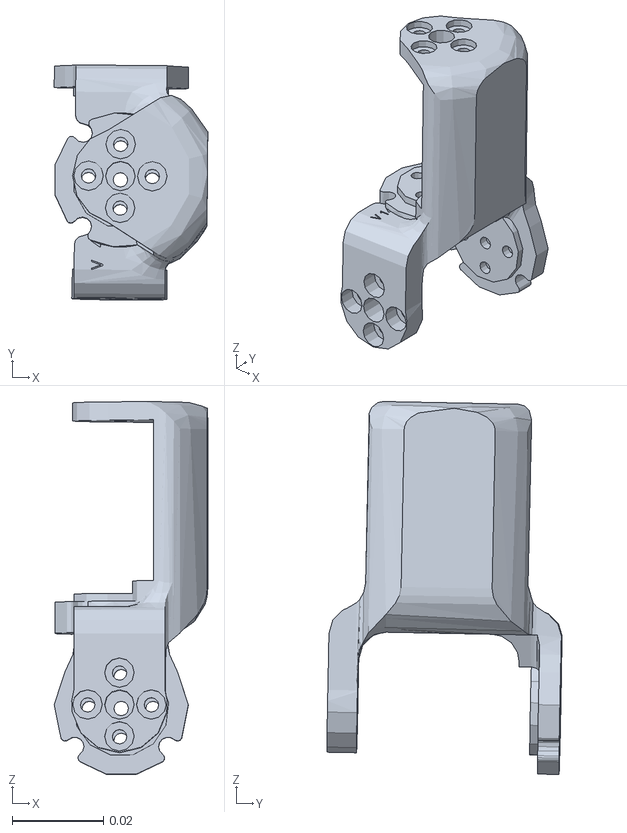
[picture p64: CAD file, 2026-09-22]
sim/assets/zbot-cad/meshes/right_hip_roll_link_printed.stl
0.0337 x 0.0517 x 0.0819
