Justin-Riekehof/zeroth-01-build/sim/assets/zbot-pixel-backpack/meshes/IMU.stl

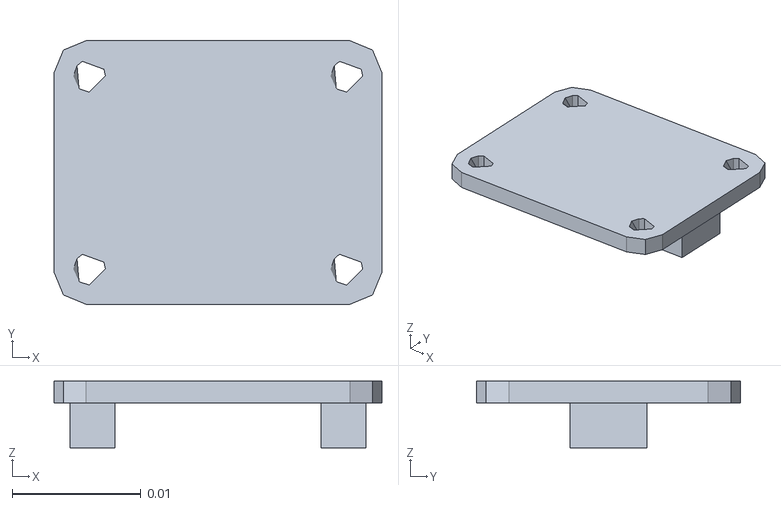
[picture p65: CAD file, 2026-08-21]
sim/assets/zbot-pixel-backpack/meshes/IMU.stl
0.0255 x 0.0205 x 0.0052
