Justin-Riekehof/zeroth-01-build/hardware/backpack_v2/stl_v3/cables/switch_in_lead.stl

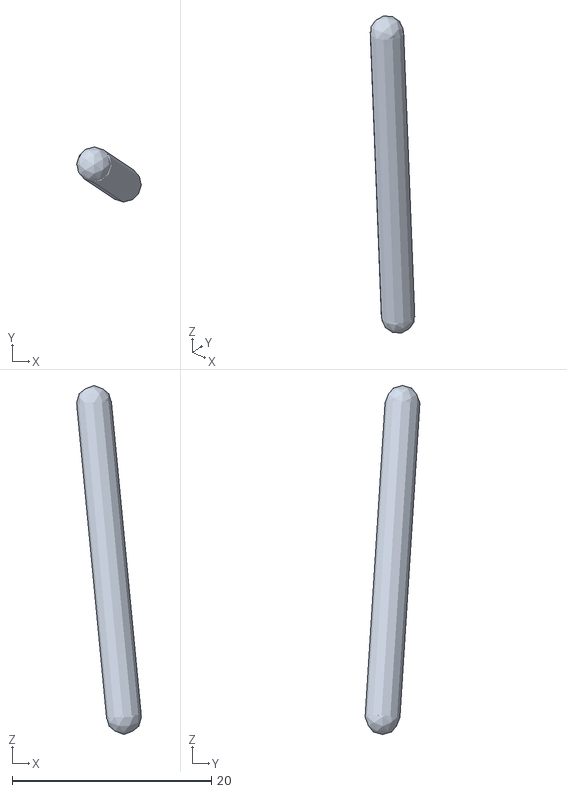
[picture p66: CAD file, 2026-09-22]
hardware/backpack_v2/stl_v3/cables/switch_in_lead.stl
6.50 x 5.50 x 35.0
