Justin-Riekehof/zeroth-01-build/sim/assets/zbot-cad/meshes/left_ankle_pitch_link_printed.stl

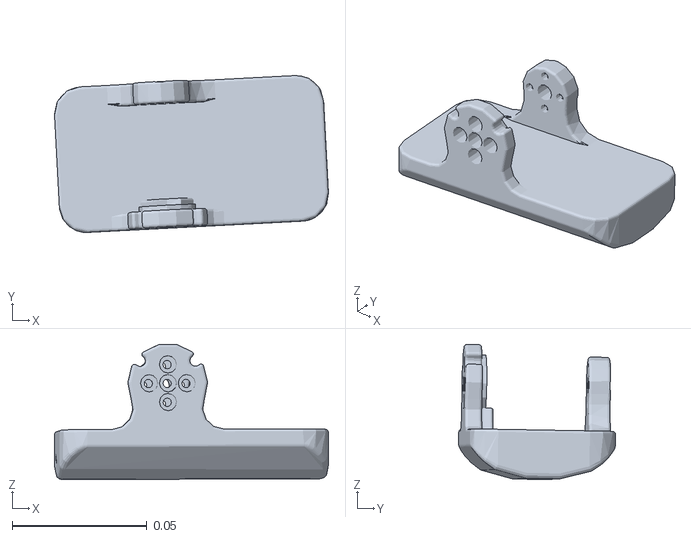
[picture p67: CAD file, 2026-09-22]
sim/assets/zbot-cad/meshes/left_ankle_pitch_link_printed.stl
0.102 x 0.0582 x 0.0502
