Justin-Riekehof/zeroth-01-build/sim/assets/zbot-pixel-backpack/meshes/Z_BOT2_MASTER_SHOULDER2_2.stl

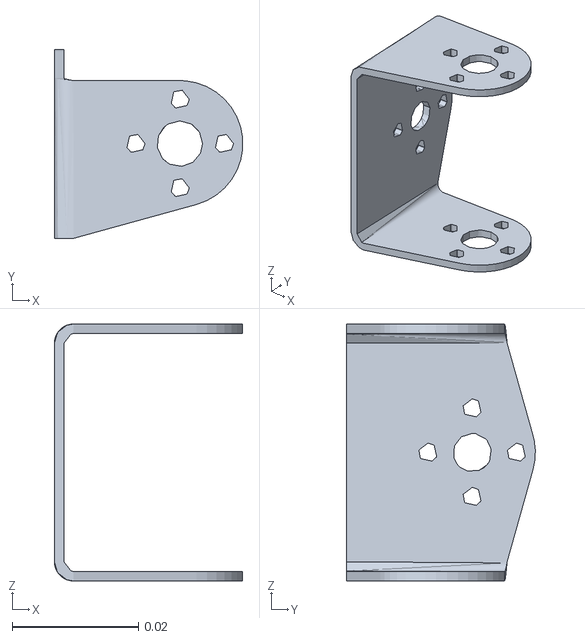
[picture p68: CAD file, 2026-08-21]
sim/assets/zbot-pixel-backpack/meshes/Z_BOT2_MASTER_SHOULDER2_2.stl
0.0298 x 0.0298 x 0.0406
