Justin-Riekehof/zeroth-01-build/hardware/backpack_v2/stl_v3/cables/fuse_leg_1.stl

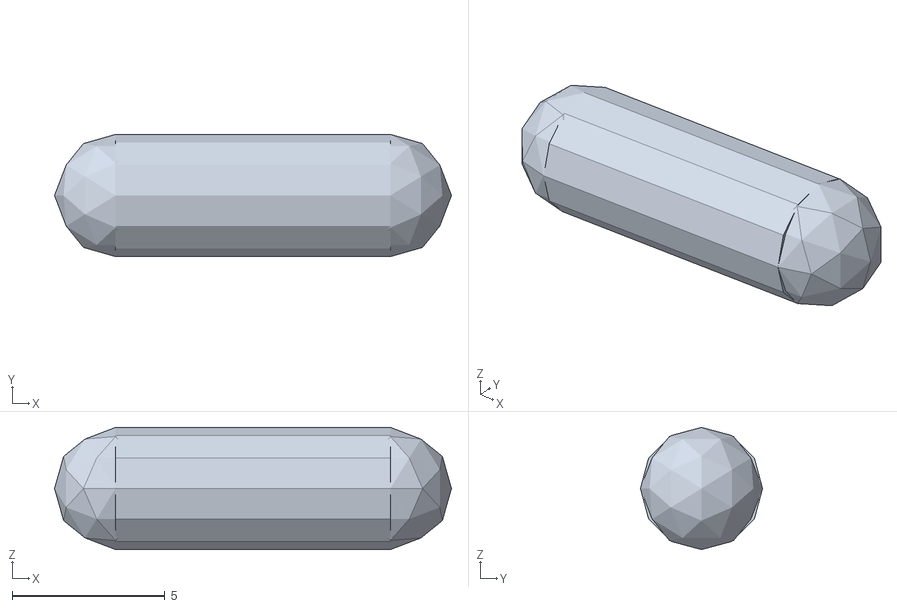
[picture p69: CAD file, 2026-09-22]
hardware/backpack_v2/stl_v3/cables/fuse_leg_1.stl
13.0 x 4.00 x 4.00
