Justin-Riekehof/zeroth-01-build/hardware/head_imu/stl/imu_d1.stl

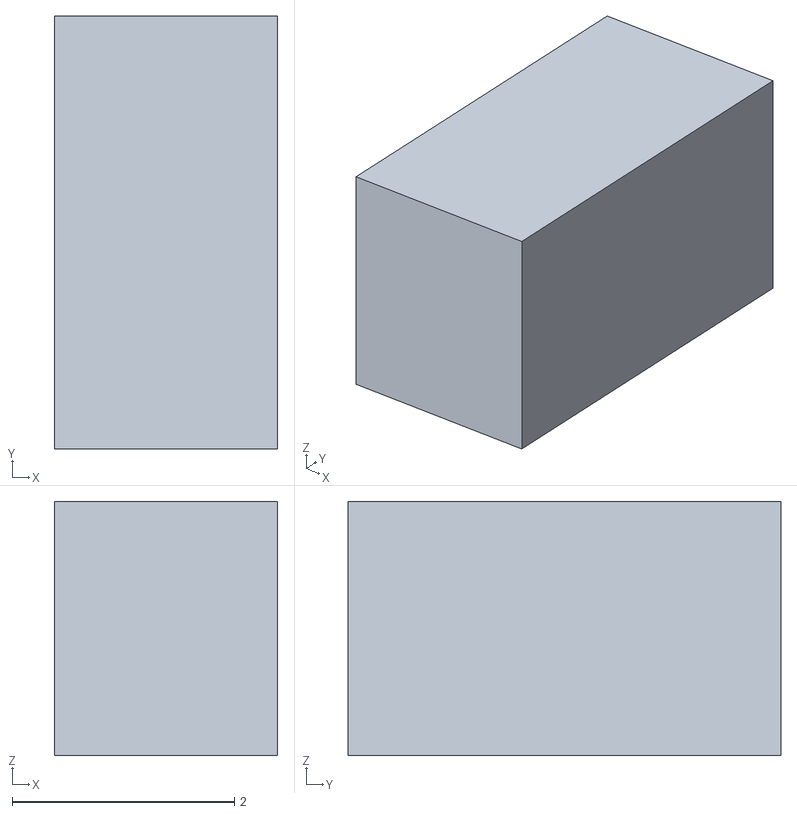
[picture p70: CAD file, 2026-09-22]
hardware/head_imu/stl/imu_d1.stl
2.01 x 3.90 x 2.29
