Justin-Riekehof/zeroth-01-build/sim/assets/zbot-cad/meshes/right_elbow_yaw_link_printed.stl

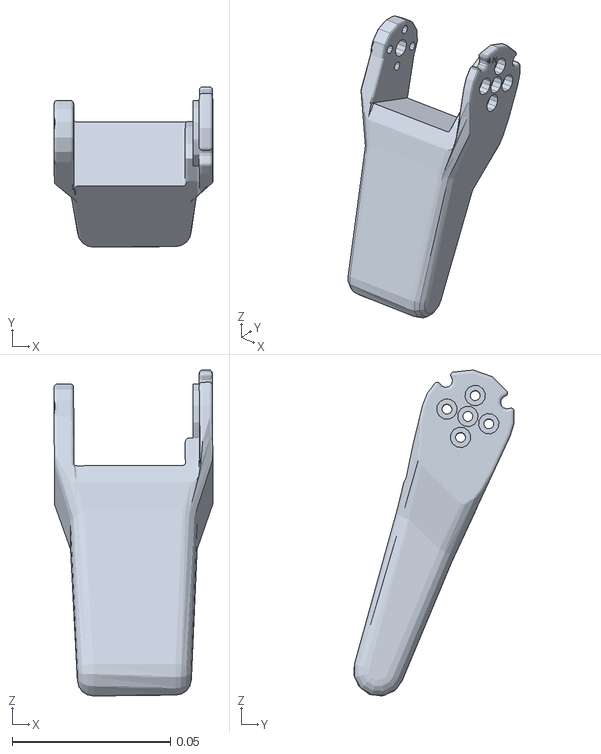
[picture p71: CAD file, 2026-09-22]
sim/assets/zbot-cad/meshes/right_elbow_yaw_link_printed.stl
0.0502 x 0.0507 x 0.103
