Justin-Riekehof/zeroth-01-build/sim/assets/zbot-pixel-backpack/meshes/FINGER_1.stl

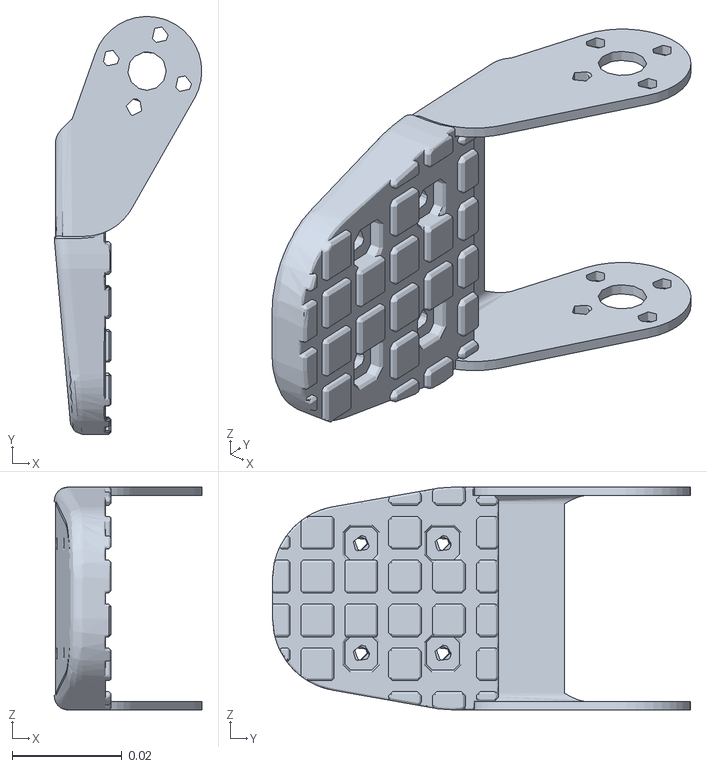
[picture p72: CAD file, 2026-08-21]
sim/assets/zbot-pixel-backpack/meshes/FINGER_1.stl
0.0269 x 0.0763 x 0.0406
