Justin-Riekehof/zeroth-01-build/hardware/backpack_v2/stl_v3/cables/lipo_balancer.stl

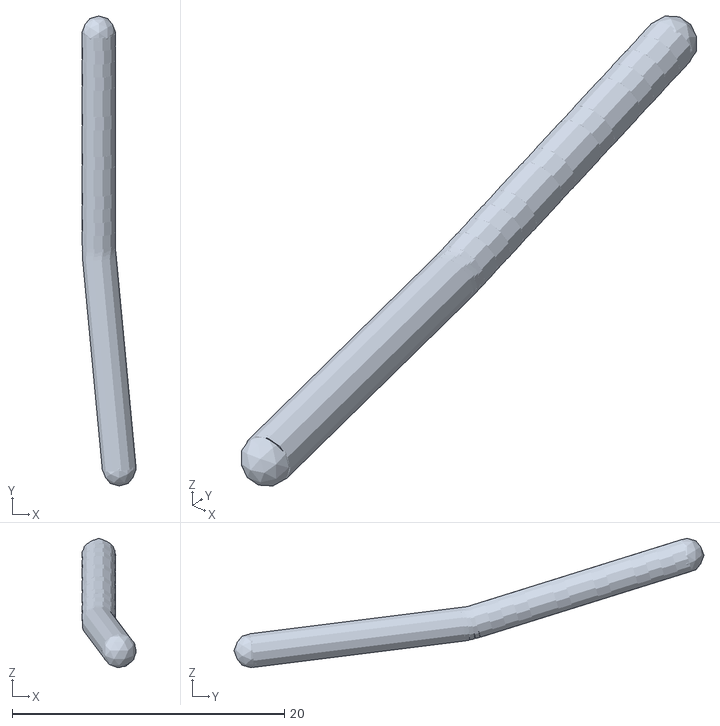
[picture p73: CAD file, 2026-09-22]
hardware/backpack_v2/stl_v3/cables/lipo_balancer.stl
4.00 x 34.5 x 9.50
