Justin-Riekehof/zeroth-01-build/hardware/head_imu/stl/imu_batt.stl

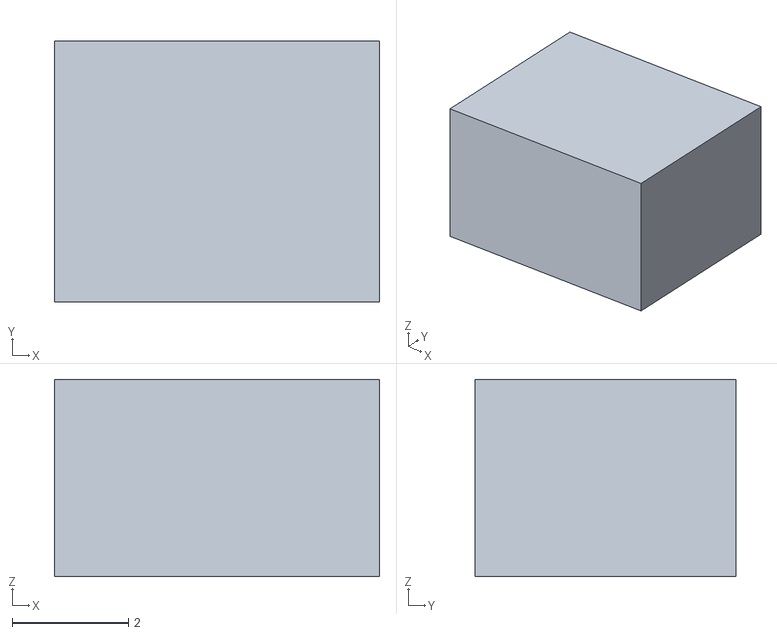
[picture p74: CAD file, 2026-09-22]
hardware/head_imu/stl/imu_batt.stl
5.60 x 4.50 x 3.40
