Justin-Riekehof/zeroth-01-build/sim/assets/zbot-cad/meshes/left_knee_pitch_link_servos.stl

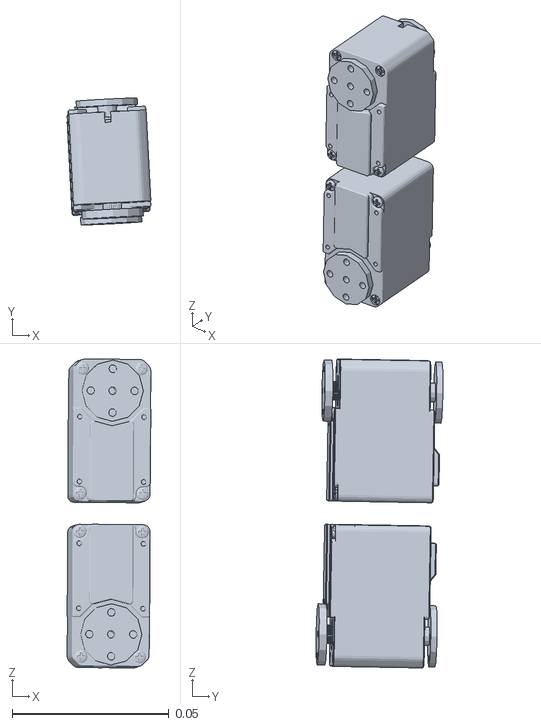
[picture p75: CAD file, 2026-09-22]
sim/assets/zbot-cad/meshes/left_knee_pitch_link_servos.stl
0.0267 x 0.0405 x 0.0985
