Justin-Riekehof/zeroth-01-build/sim/assets/zbot-pixel-backpack/meshes/3215_BothFlange_9.stl

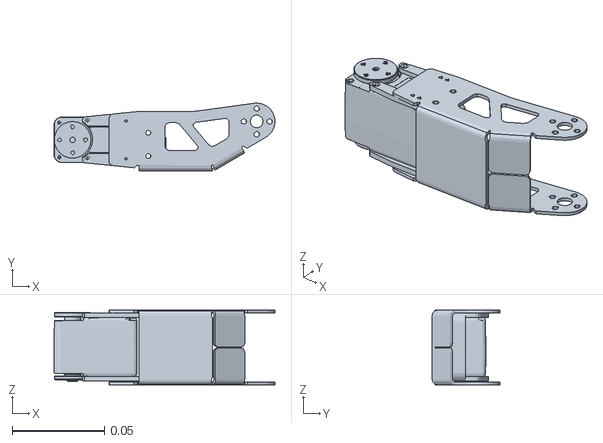
[picture p76: CAD file, 2026-08-21]
sim/assets/zbot-pixel-backpack/meshes/3215_BothFlange_9.stl
0.12 x 0.0368 x 0.0406
