Justin-Riekehof/zeroth-01-build/hardware/head_imu/stl/imu_lcd_viewarea.stl

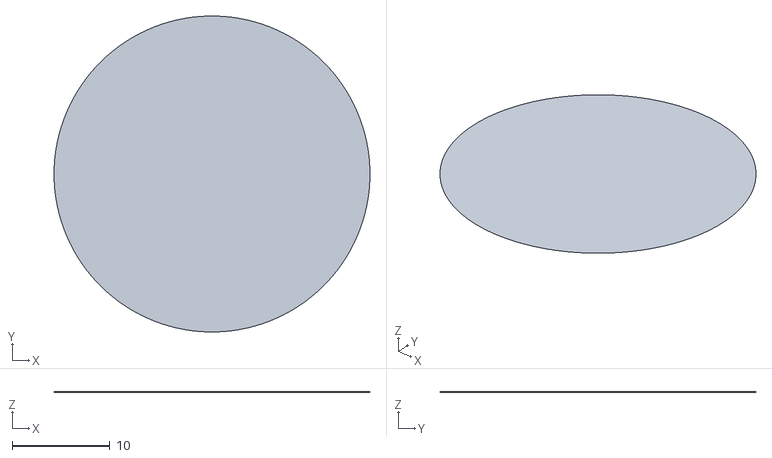
[picture p77: CAD file, 2026-09-22]
hardware/head_imu/stl/imu_lcd_viewarea.stl
32.4 x 32.4 x 0.05
