Justin-Riekehof/zeroth-01-build/sim/assets/zbot-cad/meshes/left_hip_roll_link_printed.stl

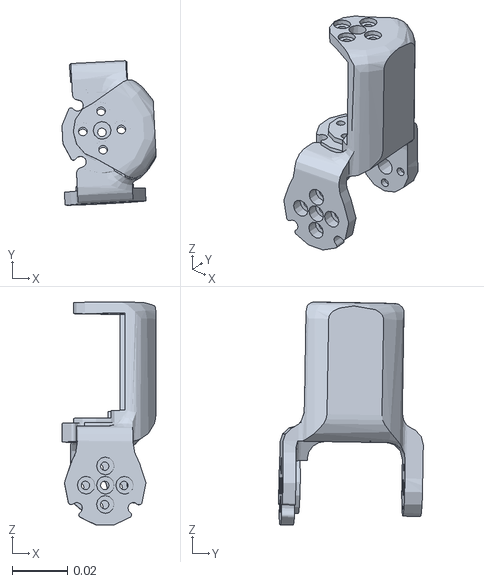
[picture p78: CAD file, 2026-09-22]
sim/assets/zbot-cad/meshes/left_hip_roll_link_printed.stl
0.0342 x 0.0526 x 0.081
