Justin-Riekehof/zeroth-01-build/sim/assets/zbot-pixel-backpack/meshes/R_ARM_MIRROR_1.stl

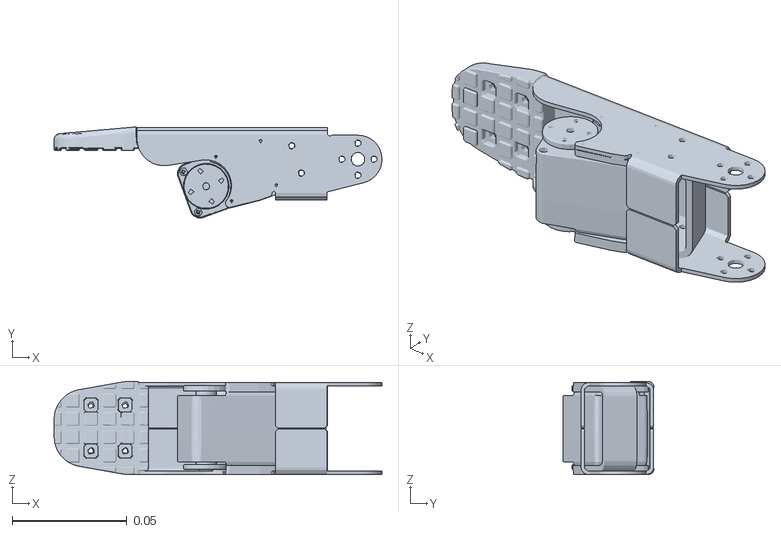
[picture p79: CAD file, 2026-08-21]
sim/assets/zbot-pixel-backpack/meshes/R_ARM_MIRROR_1.stl
0.143 x 0.0398 x 0.0406
