Justin-Riekehof/zeroth-01-build/hardware/backpack_v2/stl_v3/placeholder_cables.stl

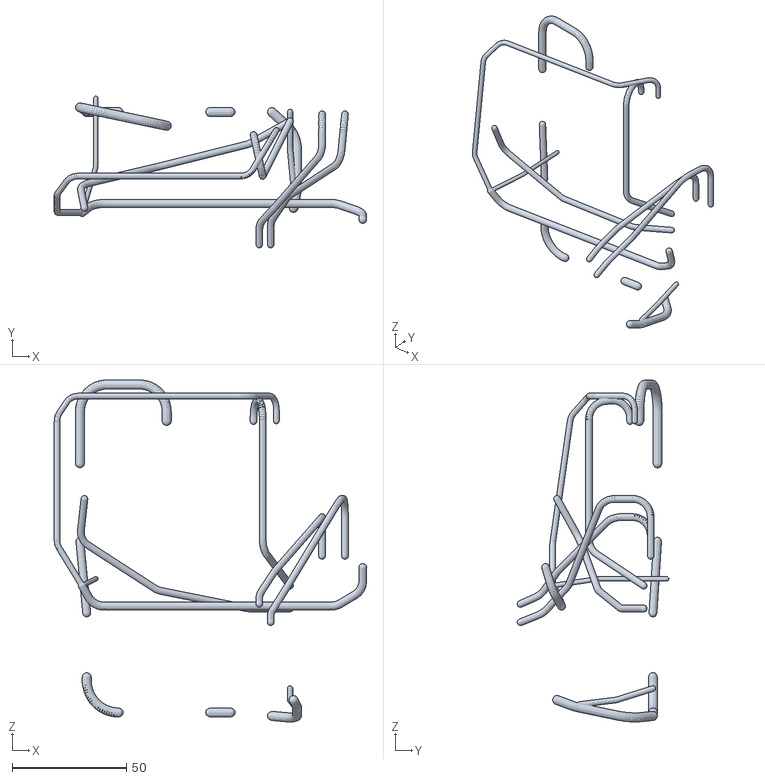
[picture p80: CAD file, 2026-10-01]
hardware/backpack_v2/stl_v3/placeholder_cables.stl
136.8 x 66.5 x 149.7
