Justin-Riekehof/zeroth-01-build/hardware/head_imu/stl/imu_adapter.step

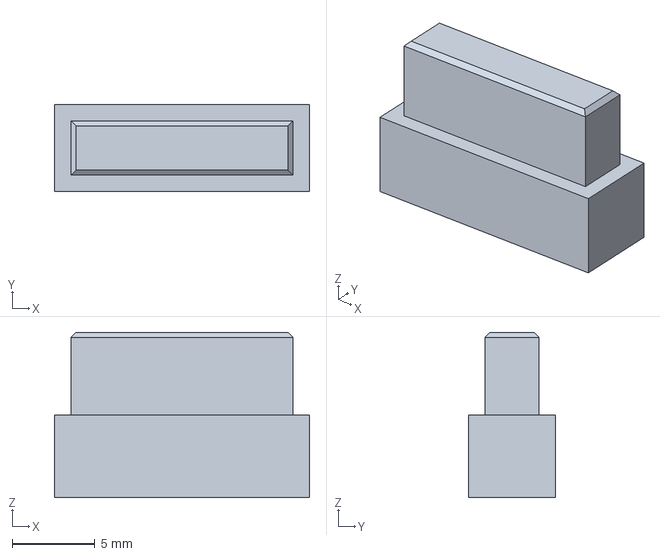
[picture p81: CAD file, 2026-09-22]
hardware/head_imu/stl/imu_adapter.step
15.4 x 5.27 x 10.0 mm
