Justin-Riekehof/zeroth-01-build/hardware/backpack_v2/stl_v3/placeholder_xt60_lipo_fuse.stl

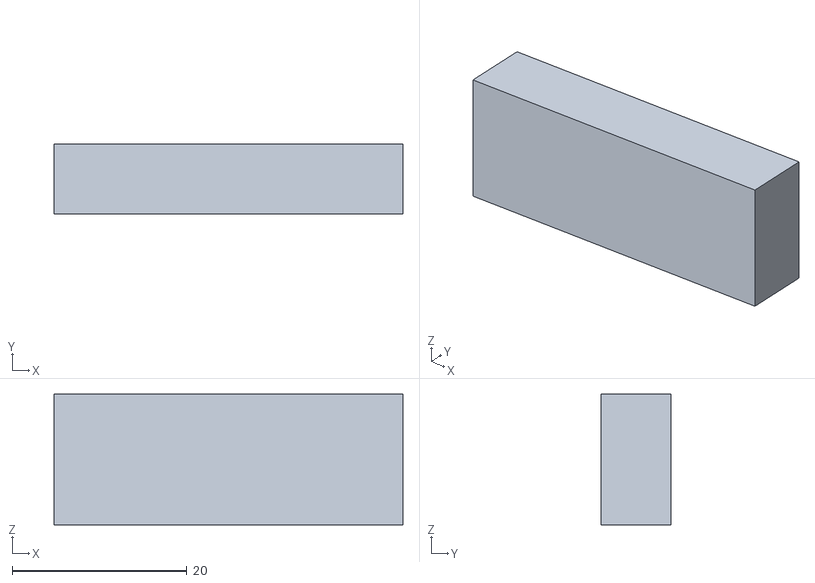
[picture p82: CAD file, 2026-09-22]
hardware/backpack_v2/stl_v3/placeholder_xt60_lipo_fuse.stl
40.0 x 8.00 x 15.0
