Justin-Riekehof/zeroth-01-build/hardware/head_imu/stl/imu_usbc.stl

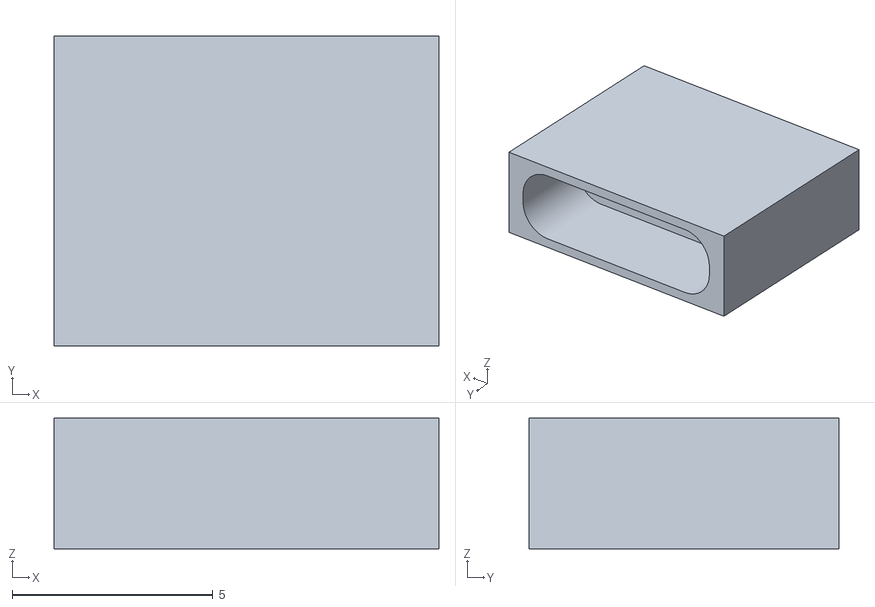
[picture p83: CAD file, 2026-09-22]
hardware/head_imu/stl/imu_usbc.stl
9.58 x 7.71 x 3.25
