Justin-Riekehof/zeroth-01-build/hardware/backpack_v2/stl_v3/placeholder_waveshare_servo_plugs.stl

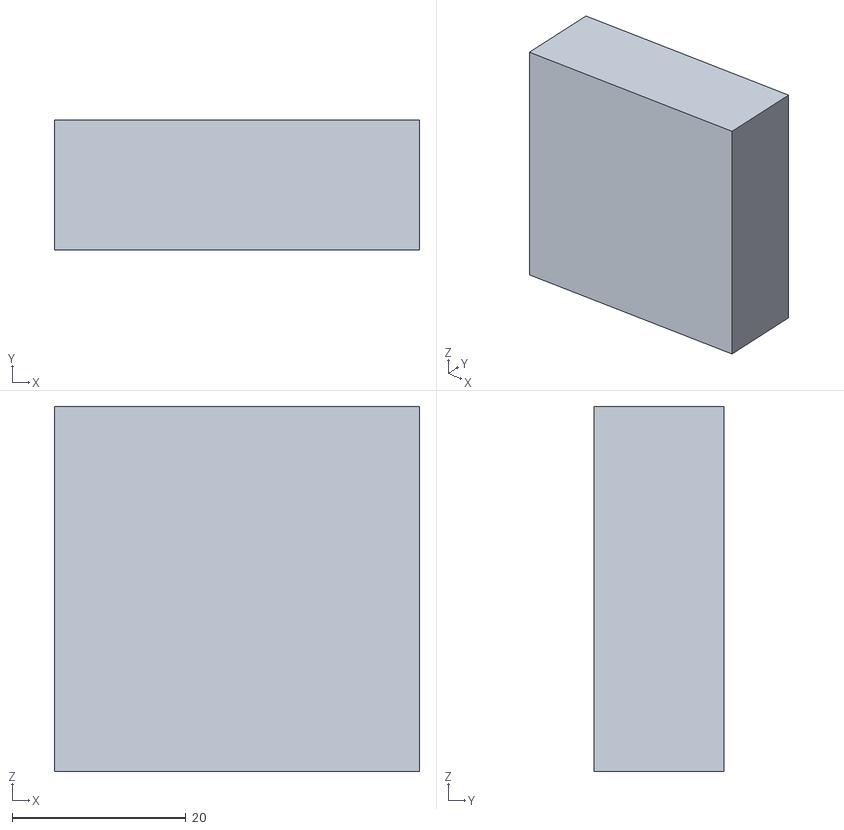
[picture p84: CAD file, 2026-09-22]
hardware/backpack_v2/stl_v3/placeholder_waveshare_servo_plugs.stl
42.0 x 15.0 x 42.0
