Justin-Riekehof/zeroth-01-build/hardware/head_imu/stl/robotframe/imu_qmi8658.stl

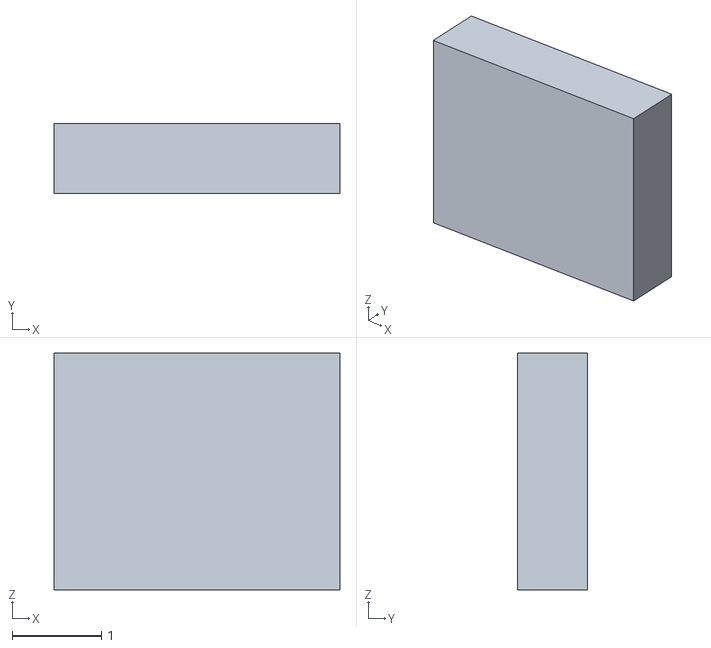
[picture p85: CAD file, 2026-09-22]
hardware/head_imu/stl/robotframe/imu_qmi8658.stl
3.20 x 0.78 x 2.65
