Justin-Riekehof/zeroth-01-build/sim/assets/zbot-cad/meshes/left_knee_pitch_link_printed.stl

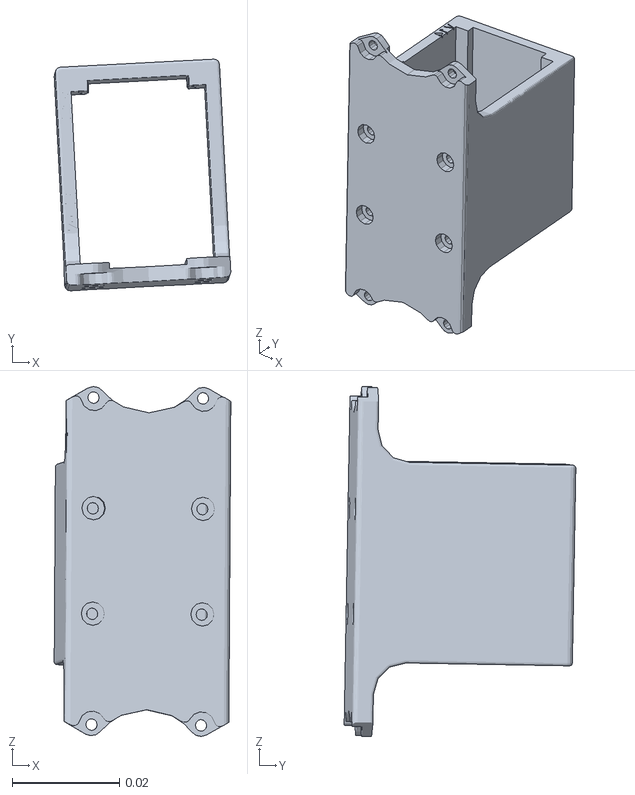
[picture p86: CAD file, 2026-09-22]
sim/assets/zbot-cad/meshes/left_knee_pitch_link_printed.stl
0.033 x 0.0433 x 0.0654
