Justin-Riekehof/zeroth-01-build/hardware/backpack_v2/stl_v3/placeholder_warner_plug.stl

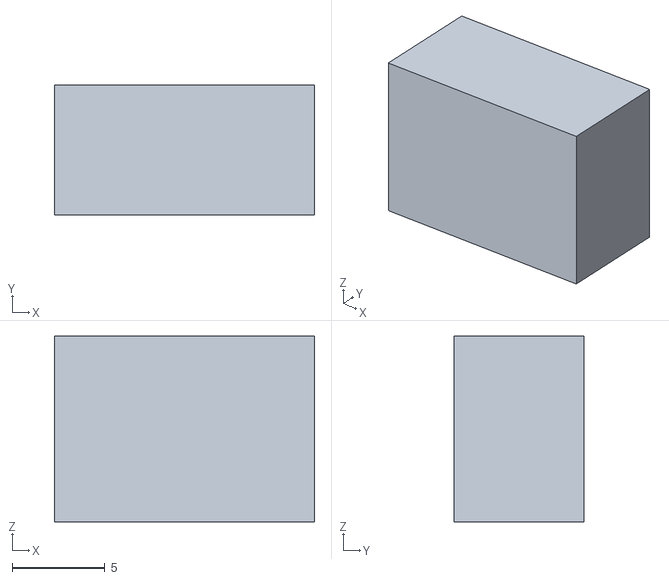
[picture p87: CAD file, 2026-09-22]
hardware/backpack_v2/stl_v3/placeholder_warner_plug.stl
14.0 x 7.00 x 10.0
