Justin-Riekehof/zeroth-01-build/hardware/head_imu/stl/imu_lcd_panel.stl

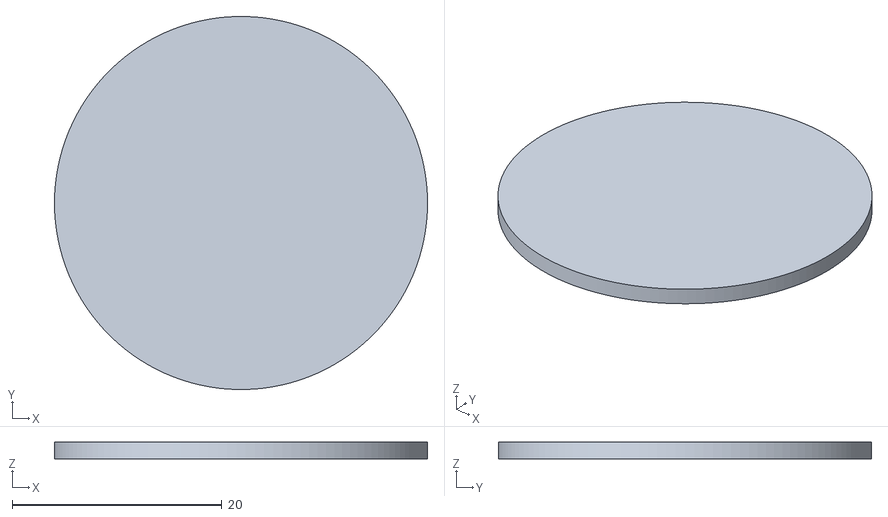
[picture p88: CAD file, 2026-09-22]
hardware/head_imu/stl/imu_lcd_panel.stl
35.6 x 35.6 x 1.60
