Justin-Riekehof/zeroth-01-build/sim/assets/zbot-cad/meshes/right_knee_pitch_link_servos.stl

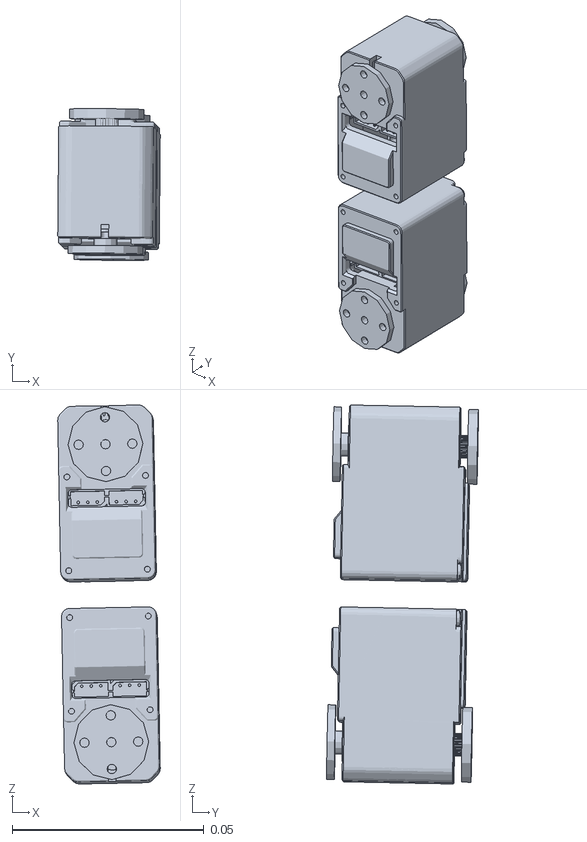
[picture p89: CAD file, 2026-09-22]
sim/assets/zbot-cad/meshes/right_knee_pitch_link_servos.stl
0.0267 x 0.0396 x 0.0988
