Justin-Riekehof/zeroth-01-build/sim/assets/zbot-pixel-backpack/meshes/Z_BOT2_MASTER_BODY_SKELETON.stl

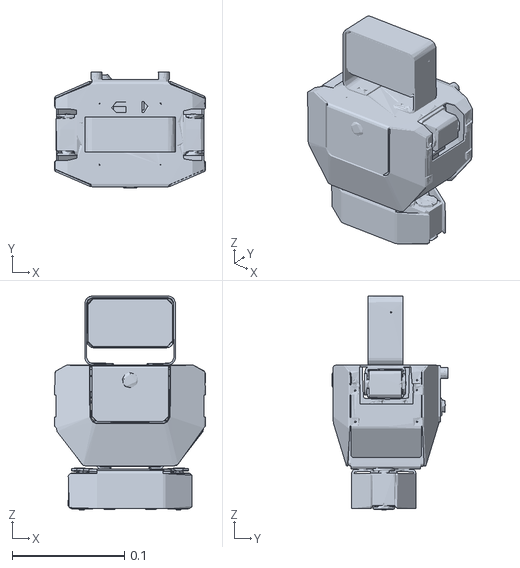
[picture p90: CAD file, 2026-08-21]
sim/assets/zbot-pixel-backpack/meshes/Z_BOT2_MASTER_BODY_SKELETON.stl
0.135 x 0.104 x 0.191
