Justin-Riekehof/zeroth-01-build/hardware/backpack_v2/stl_v3/placeholder_fuse_holder.stl

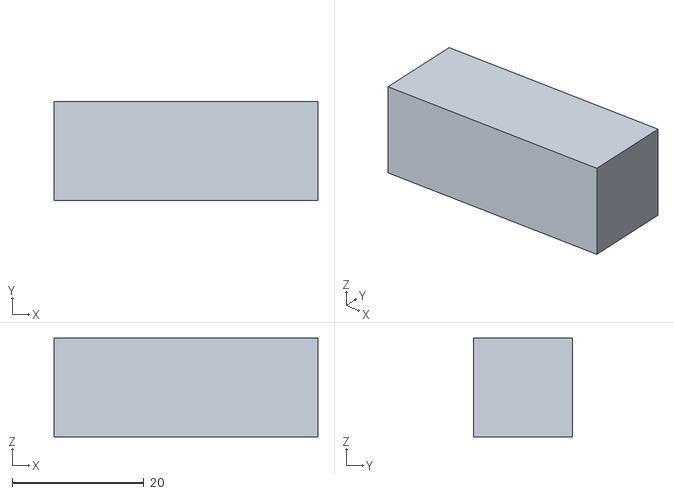
[picture p91: CAD file, 2026-09-22]
hardware/backpack_v2/stl_v3/placeholder_fuse_holder.stl
40.0 x 15.0 x 15.0
