Justin-Riekehof/zeroth-01-build/sim/assets/zbot-pixel-backpack/meshes/3215_BothFlange_14.stl

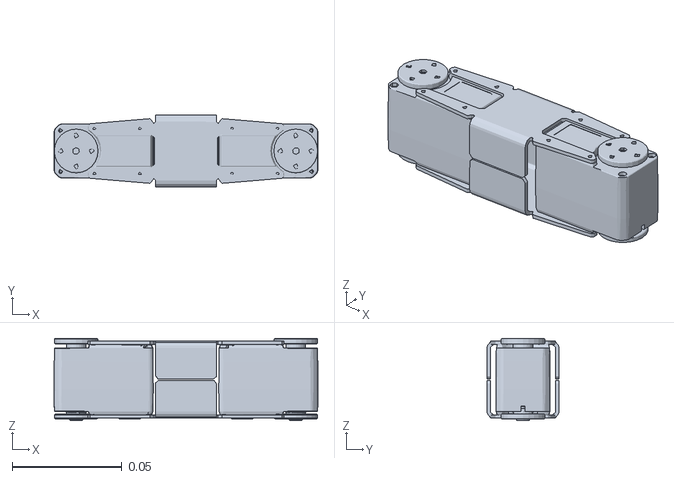
[picture p92: CAD file, 2026-08-21]
sim/assets/zbot-pixel-backpack/meshes/3215_BothFlange_14.stl
0.12 x 0.0328 x 0.0374
