Justin-Riekehof/zeroth-01-build/hardware/backpack_v2/stl_v3/placeholder_cutoff_out_wires.stl

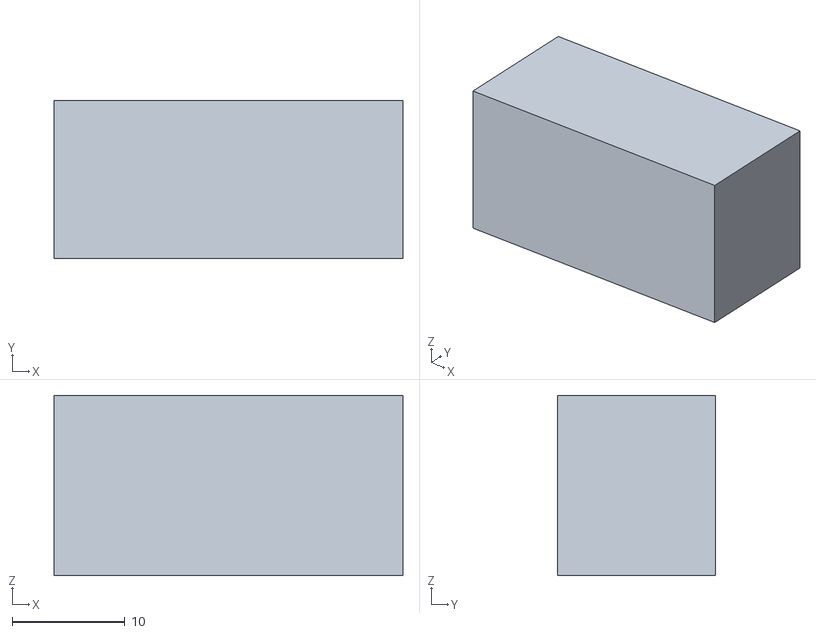
[picture p93: CAD file, 2026-09-22]
hardware/backpack_v2/stl_v3/placeholder_cutoff_out_wires.stl
31.0 x 14.0 x 16.0
