Justin-Riekehof/zeroth-01-build/sim/assets/zbot-cad/meshes/right_shoulder_yaw_link_printed.stl

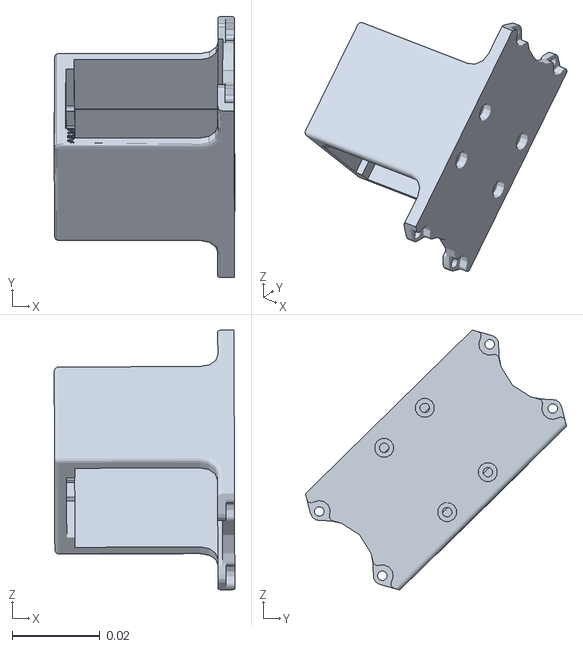
[picture p94: CAD file, 2026-09-22]
sim/assets/zbot-cad/meshes/right_shoulder_yaw_link_printed.stl
0.0412 x 0.0595 x 0.0592
