Justin-Riekehof/zeroth-01-build/hardware/backpack_v2/stl_v3/placeholder_warner.stl

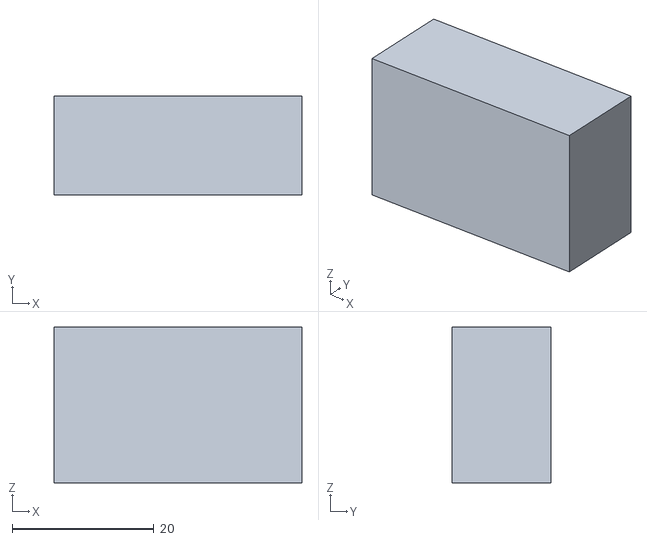
[picture p95: CAD file, 2026-09-22]
hardware/backpack_v2/stl_v3/placeholder_warner.stl
35.0 x 14.0 x 22.0
