Justin-Riekehof/zeroth-01-build/hardware/head_imu/stl/imu_qmi8658.stl

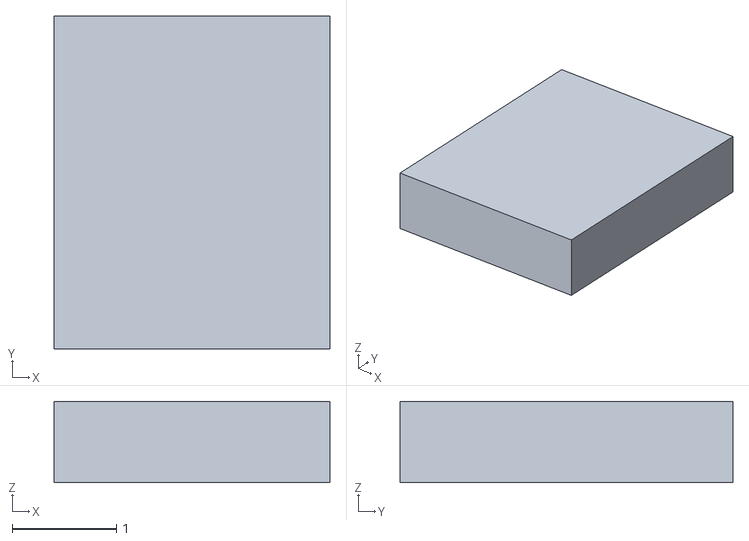
[picture p96: CAD file, 2026-09-22]
hardware/head_imu/stl/imu_qmi8658.stl
2.65 x 3.20 x 0.78
