Justin-Riekehof/zeroth-01-build/sim/assets/zbot-cad/meshes/right_shoulder_yaw_link_servos.stl

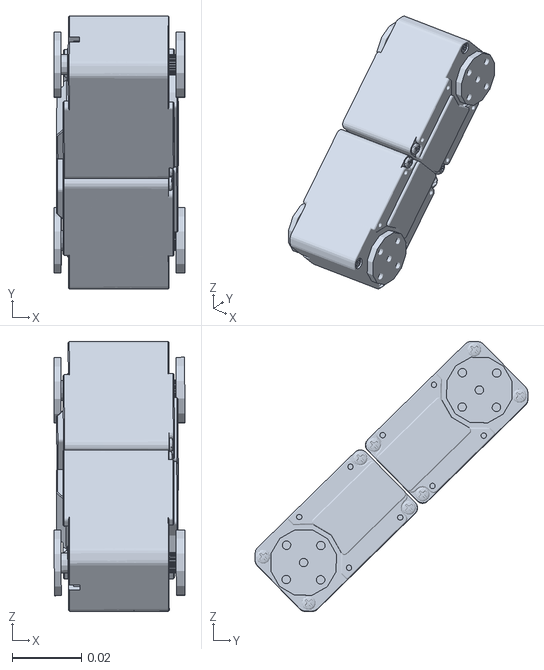
[picture p97: CAD file, 2026-09-22]
sim/assets/zbot-cad/meshes/right_shoulder_yaw_link_servos.stl
0.0377 x 0.0787 x 0.0779
