Justin-Riekehof/zeroth-01-build/sim/assets/zbot-pixel-backpack/meshes/3215_BothFlange_5.stl

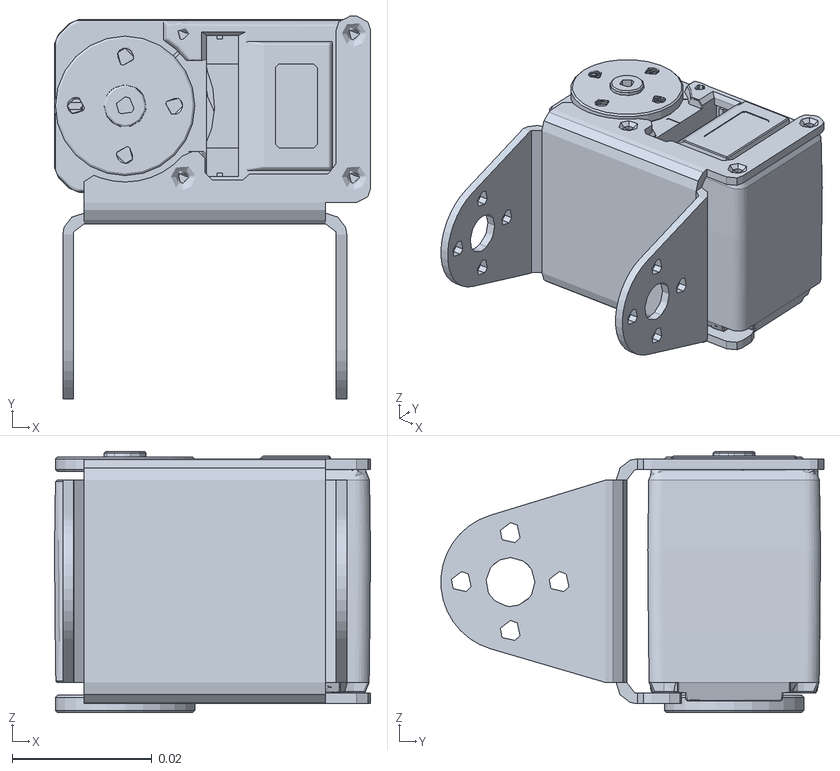
[picture p98: CAD file, 2026-08-21]
sim/assets/zbot-pixel-backpack/meshes/3215_BothFlange_5.stl
0.0452 x 0.0548 x 0.0374
