Justin-Riekehof/zeroth-01-build/hardware/backpack_v2/stl_v3/placeholder_cutoff.stl

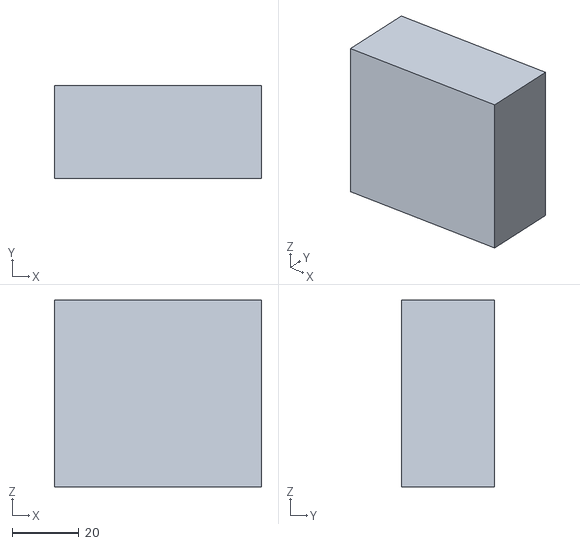
[picture p99: CAD file, 2026-09-22]
hardware/backpack_v2/stl_v3/placeholder_cutoff.stl
62.0 x 28.0 x 56.0
