Justin-Riekehof/zeroth-01-build/hardware/backpack_v2/stl_v3/placeholder_lipo.stl

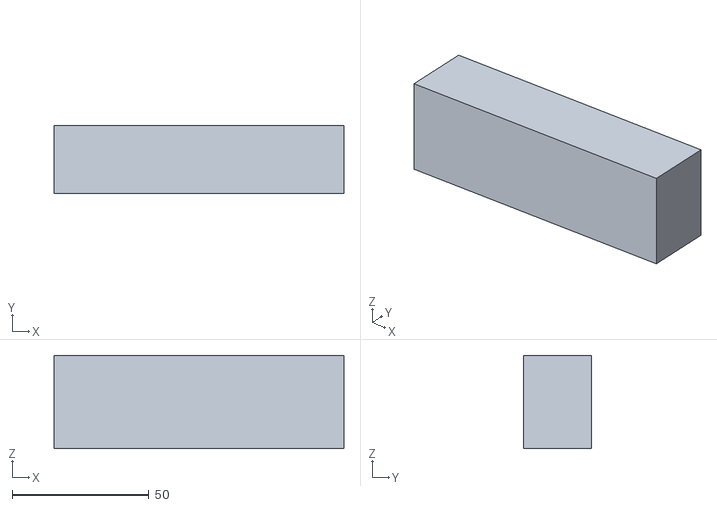
[picture p100: CAD file, 2026-09-22]
hardware/backpack_v2/stl_v3/placeholder_lipo.stl
106.0 x 25.0 x 34.0
