Justin-Riekehof/zeroth-01-build/sim/assets/zbot-cad/meshes/left_elbow_yaw_link_printed.stl

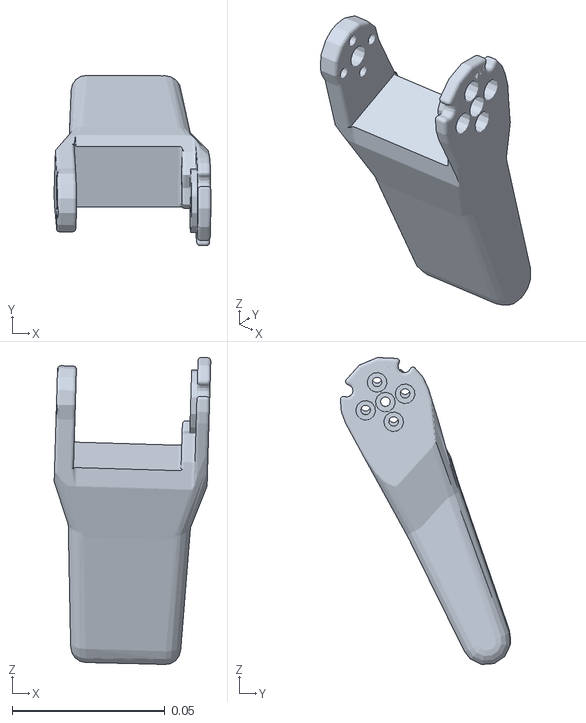
[picture p101: CAD file, 2026-09-22]
sim/assets/zbot-cad/meshes/left_elbow_yaw_link_printed.stl
0.0513 x 0.0557 x 0.1
