Justin-Riekehof/zeroth-01-build/hardware/backpack_v2/stl_v3/placeholder_waveshare.stl

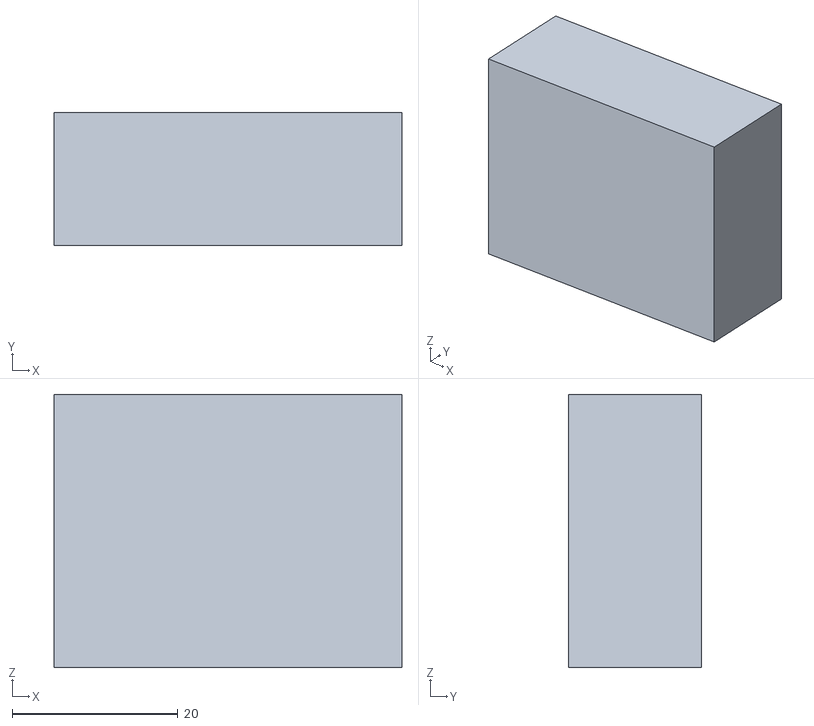
[picture p102: CAD file, 2026-09-22]
hardware/backpack_v2/stl_v3/placeholder_waveshare.stl
42.0 x 16.0 x 33.0
