Justin-Riekehof/zeroth-01-build/sim/assets/zbot-cad/meshes/left_shoulder_yaw_link_servos.stl

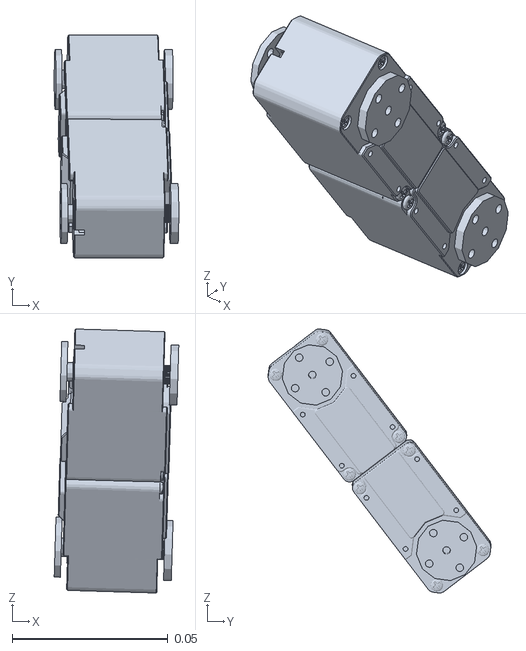
[picture p103: CAD file, 2026-09-22]
sim/assets/zbot-cad/meshes/left_shoulder_yaw_link_servos.stl
0.0401 x 0.0716 x 0.0848
