Justin-Riekehof/zeroth-01-build/sim/assets/zbot-pixel-backpack/meshes/3215_BothFlange_13.stl

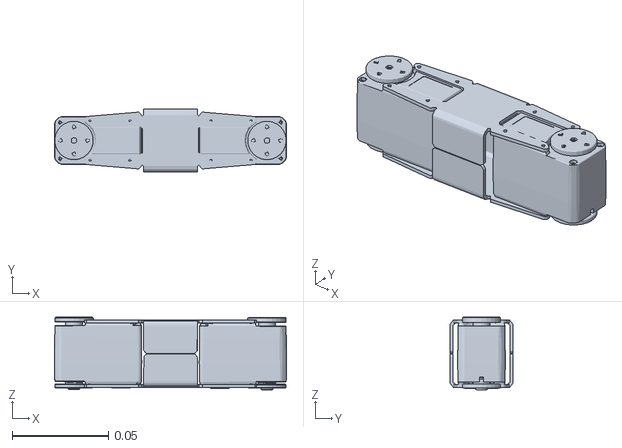
[picture p104: CAD file, 2026-08-21]
sim/assets/zbot-pixel-backpack/meshes/3215_BothFlange_13.stl
0.12 x 0.0328 x 0.0376
