Justin-Riekehof/zeroth-01-build/hardware/backpack_v2/stl_v3/placeholder_waveshare_plugs.stl

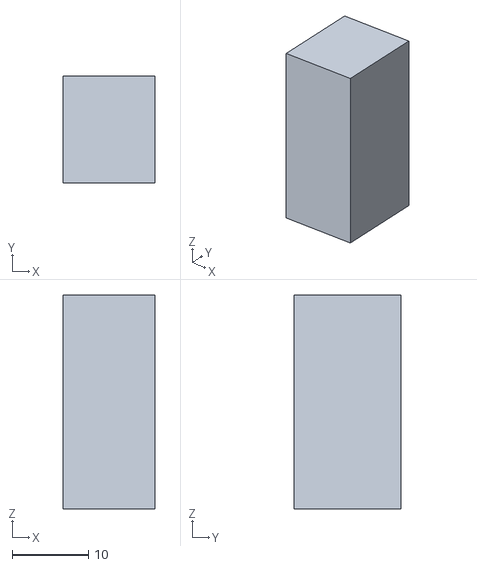
[picture p105: CAD file, 2026-09-22]
hardware/backpack_v2/stl_v3/placeholder_waveshare_plugs.stl
12.0 x 14.0 x 28.0
