Justin-Riekehof/zeroth-01-build/hardware/backpack_v2/stl_v3/placeholder_xt60_fuse_switch.stl

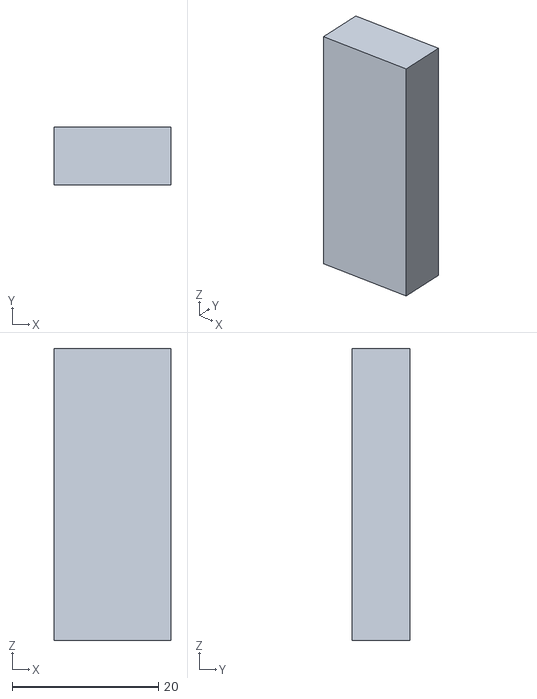
[picture p106: CAD file, 2026-09-22]
hardware/backpack_v2/stl_v3/placeholder_xt60_fuse_switch.stl
16.0 x 8.00 x 40.0
