Justin-Riekehof/zeroth-01-build/sim/assets/zbot-cad/meshes/right_shoulder_pitch_link_printed.stl

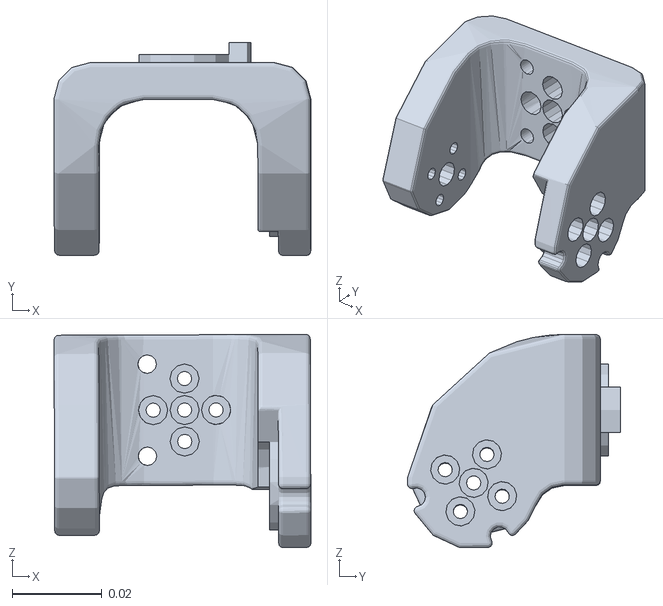
[picture p107: CAD file, 2026-09-22]
sim/assets/zbot-cad/meshes/right_shoulder_pitch_link_printed.stl
0.0572 x 0.0474 x 0.0475
