Justin-Riekehof/zeroth-01-build/hardware/backpack_v2/stl_v3/placeholder_switch.stl

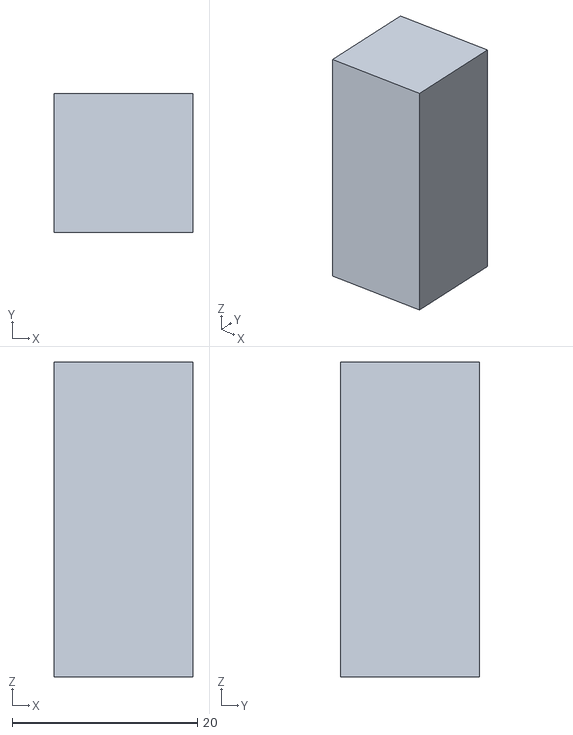
[picture p108: CAD file, 2026-09-22]
hardware/backpack_v2/stl_v3/placeholder_switch.stl
15.0 x 15.0 x 34.0
