Justin-Riekehof/zeroth-01-build/sim/assets/zbot-cad/meshes/right_ankle_pitch_link_printed.stl

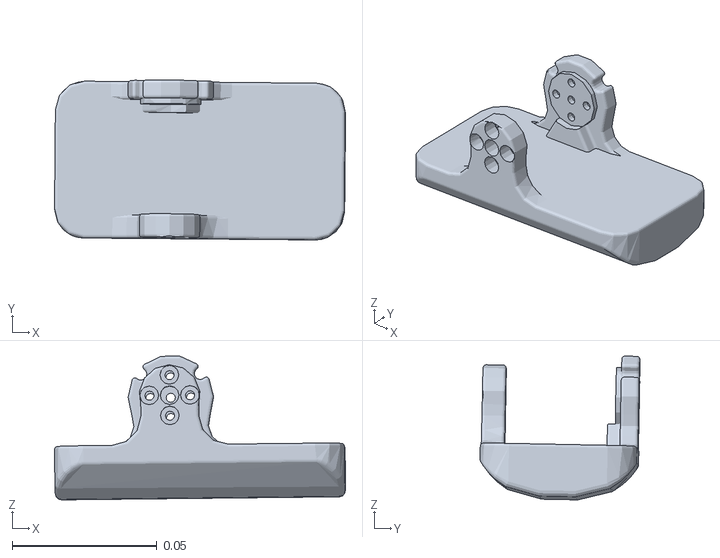
[picture p109: CAD file, 2026-09-22]
sim/assets/zbot-cad/meshes/right_ankle_pitch_link_printed.stl
0.1 x 0.0552 x 0.0496
