Justin-Riekehof/zeroth-01-build/sim/assets/zbot-cad/meshes/left_shoulder_yaw_link_printed.stl

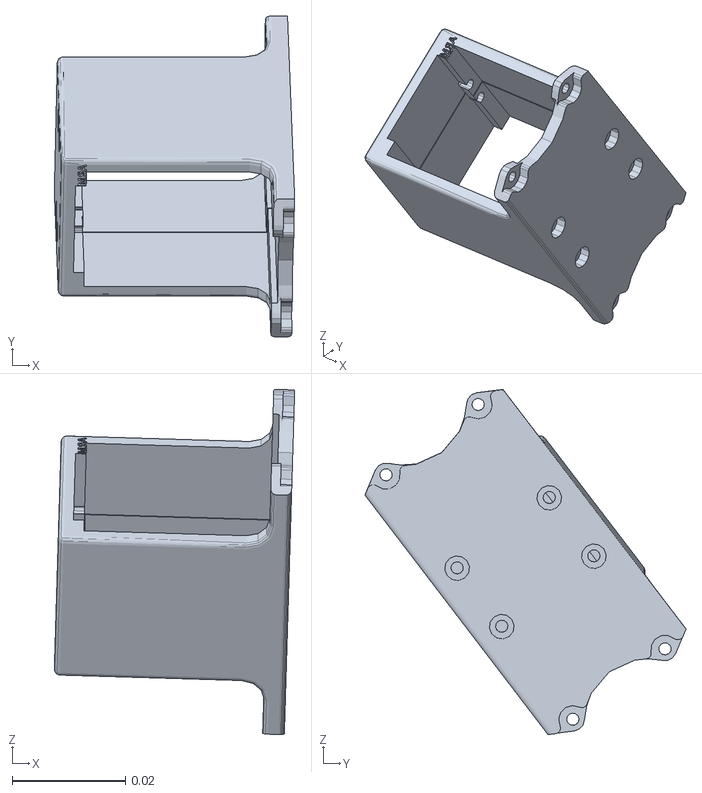
[picture p110: CAD file, 2026-09-22]
sim/assets/zbot-cad/meshes/left_shoulder_yaw_link_printed.stl
0.0425 x 0.0567 x 0.061
