Justin-Riekehof/zeroth-01-build/(list of files, cad)

Other CAD files:
hardware/head_imu/stl/robotframe/neck_mount_imu.stl
sim/assets/zbot-pixel-backpack/meshes/backpack_base.stl
hardware/head_cam/stl/robotframe/head_shell_cam3.stl
hardware/head_imu/stl/robotframe/imu_axis_y.stl
hardware/backpack_v2/print/v3.1_scharfkantig/pixel-backpack-v3.1_3-torso-insert.stl
hardware/head_imu/stl/robotframe/imu_adapter_h2.stl
sim/assets/zbot-pixel-backpack/meshes/backpack_lid.stl
hardware/head_imu/stl/imu_adapter_h2.stl
hardware/head_imu/stl/imu_axis_y.stl
hardware/backpack_v2/stl_v3/backpack_v3_base_robotframe.stl
hardware/head_imu/stl/imu_axis_z.stl
hardware/head_imu/stl/robotframe/imu_rp2040.stl
hardware/head_imu/stl/robotframe/imu_adapter_h1.stl
sim/assets/zbot-pixel-backpack/meshes/3215_1Flange_2.stl
hardware/head_imu/stl/imu_hdr_h1.stl
hardware/backpack_v2/stl_v3/backpack_v3_lid_robotframe.stl
hardware/head_imu/stl/robotframe/imu_pcb.stl
sim/assets/zbot-pixel-backpack/meshes/FOOT.collision.stl
hardware/head_imu/stl/imu_sw_reset.stl
hardware/head_imu/stl/robotframe/imu_hdr_h1.stl
hardware/head_imu/stl/robotframe/imu_axis_z.stl
hardware/head_imu/stl/robotframe/imu_d1.stl
hardware/head_imu/stl/robotframe/imu_lcd_viewarea.stl
hardware/head_imu/stl/robotframe/imu_sw_reset.stl
sim/assets/zbot-cad/meshes/right_hip_yaw_link_servos.stl
sim/assets/zbot-pixel-backpack/meshes/3215_BothFlange_10.stl
hardware/head_imu/stl/robotframe/imu_axis_x.stl
sim/assets/zbot-cad/meshes/left_hip_pitch_link_printed.stl
sim/assets/zbot-pixel-backpack/meshes/FOOT_2.stl
hardware/head_imu/stl/imu_sw_boot.stl
sim/assets/zbot-pixel-backpack/meshes/U_HIP_R.stl
hardware/head_imu/stl/robotframe/imu_lcd_panel.stl
hardware/head_imu/stl/imu_adapter_flush.stl
hardware/head_imu/stl/robotframe/imu_batt.stl
sim/assets/zbot-cad/meshes/right_hip_pitch_link_servos.stl
hardware/head_imu/stl/imu_l1.stl
hardware/head_imu/stl/robotframe/imu_usbc.stl
sim/assets/zbot-pixel-backpack/meshes/Z_BOT2_MASTER_SHOULDER2.stl
hardware/head_imu/stl/imu_hdr_h2.stl
sim/assets/zbot-cad/meshes/left_hip_yaw_link_printed.stl
sim/assets/zbot-pixel-backpack/meshes/L_ARM_MIRROR_1.stl
sim/assets/zbot-pixel-backpack/meshes/FINGER_1_2.stl
sim/assets/zbot-cad/meshes/left_hip_yaw_link_servos.stl
sim/assets/zbot-pixel-backpack/meshes/3215_BothFlange_6.stl
hardware/backpack_v2/stl_v3/placeholder_cutoff_vin_wires.stl
hardware/backpack_v2/stl/backpack_v2_base.stl
hardware/backpack_v2/stl/backpack_v2_base_robotframe.stl
hardware/backpack_v2/stl/backpack_v2_deck.stl
hardware/backpack_v2/stl/backpack_v2_deck_robotframe.stl
hardware/backpack_v2/stl/backpack_v2_lid.stl
hardware/backpack_v2/stl/backpack_v2_lid_robotframe.stl
hardware/backpack_v2/stl/placeholder_cutoff.stl
hardware/backpack_v2/stl/placeholder_fuse_holder.stl
hardware/backpack_v2/stl/placeholder_lipo.stl
hardware/backpack_v2/stl/placeholder_pi.stl
hardware/backpack_v2/stl/placeholder_pi_usb_plugs.stl
hardware/backpack_v2/stl/placeholder_pololu.stl
hardware/backpack_v2/stl/placeholder_switch.stl
hardware/backpack_v2/stl/placeholder_warner.stl
hardware/backpack_v2/stl/placeholder_waveshare.stl
hardware/backpack_v2/stl_v3/placeholder_cutoff_screws.stl
hardware/backpack_v2/stl_v3/placeholder_pi_screws.stl
hardware/head_imu/stl/imu_adapter.stl
