Justin-Riekehof/zeroth-01-build/media/print-timelapse.gif

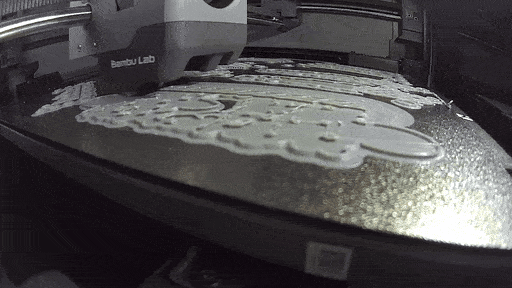
media/print-timelapse.gif
