Justin-Riekehof/zeroth-01-build/(commit log)

2026-07-04 Add 3D-print time-lapse
2026-07-19 Upper body assembled & calibrated; add servo test GUI and CAD-pinned tooling
    - Servo test & visualization GUI (FastAPI + three.js, src/servo_gui/):
    clickable 3D CAD model with joint axes/centers from OnShape revolute
    mates, single-servo sweep tests with live gauge, posable kinematic rig,
    group runs (sequential/simultaneous), daisy-chain tools (scan, set ID),
    simulation mode
    - Pinned CAD reference ([0]th Z001 / assembly Opus, immutable microversion)
    with local GLB + joint-data snapshots and download scripts (resources/cad/)
    - Calibration convention: tick 2048 = 0 deg = assembly pose
    - Hardware configs: servo IDs (11-13/21-23), per-joint safe limits
    (GUI-editable, mirrored, server-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
    [servo_ids.json, servo_map.json]
2026-07-19 Add Web GUI screenshots and demo GIF to the docs
    Captured headless (simulation mode): GUI overview, selected joint with
    CAD-anchored gauge, and a demo GIF ending in a simultaneous group sweep.
2026-07-20 Sync servo_ids.json from GUI save-mapping
    When the saved part belongs to a CAD joint, save mapping now also updates
    the canonical joint->ID config that drives group runs — leg onboarding
    becomes fully GUI-driven: flash ID, click joint, save mapping.
    [servo_ids.json, servo_map.json]
2026-07-20 Document planned leg servo IDs (31-35 / 41-45)
2026-07-20 List planned leg servos in group config; skip non-responding servos in group runs
    [servo_ids.json]
2026-07-20 Per-joint mount offsets (zero calibration off tick 2048)
    left_hip_pitch is mounted +90 deg off center: its CAD zero now maps to
    tick 3072. Offsets live in hardware/joint_offsets.json (GUI: save offset)
    and are applied in single tests, move-to-center, group runs and the live
    display. Existing hip_pitch limits converted into the offset-corrected
    frame ([40,90] pre-offset -> [-50,0]).
    [server.py]
2026-07-20 Fix hip config: restore right_hip_pitch ID 41, convert left_hip_pitch limits to offset frame
    [servo_ids.json]
2026-07-21 servo GUI: live position readout, re-zero, ID sync + hardening
    Features:
    - Live position readout: while connected + a joint is selected, poll the
    servo (GET /api/servo_pos) and show its current CAD-frame angle + drive the
    gauge needle, so you can hand-turn the output and watch it.
    - Re-zero (POST /api/zero, button 'set current position as zero'): capture the
    servo's current encoder position as the joint's 0 deg; the mount offset
    absorbs the shift. Existing joint limits are shifted by the same amount so
    they keep protecting the identical physical stops.
    - Clicking a joint retrieves its configured ID from servo_ids.json; setting an
    ID (set ID or the field) auto-selects the matching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
    [servo_map.json]
2026-07-21 Group list: gray out servos not present on the bus
    Add GET /api/present (pings every configured servo ID and returns which
    respond). On connect the GUI grays out and disables the group-list entries
    for servos not on the bus; 'All' and 'run group' only act on present servos.
    'scan bus' also refreshes availability, and group selection is now preserved
    across re-renders. Servos light up as the daisy chain is wired.
2026-07-26 Group tests: hold-center demo mode + release torque
    With 'hold center after test' (checkbox, default on), each sequentially
    tested joint returns to its center (mount offset applied) and keeps torque
    ON, so the already-tested chain holds a stable pose while the remaining
    joints run; simultaneous mode parks all at center at the end. On success
    the held servos skip the torque-off; Stop/error remains an E-stop that
    releases everything. New POST /api/release + GUI button to let go after
    the demo.
    [server.py]
2026-07-26 Hold-center: explicit verified torque-on when parking; API version handshake
    Instead of trusting that the position command leaves torque enabled, parking
    a joint in hold mode now explicitly writes TORQUE_ENABLE=1 and reads it back,
    logging 'torque ON (verified)' per joint. Also adds an API version to
    /api/status; the frontend warns loudly in the log when the running backend is
    older than the frontend expects (the recurring stale-server failure mode).
    [server.py, servo_bus.py]
2026-07-26 Serve GUI files with Cache-Control: no-store
    A browser-cached stale frontend silently missed new controls (hold-center
    checkbox). GUI assets are now never cached; the 16 MB GLB stays cacheable.
    [server.py]
2026-07-26 Hold watchdog + hold option for single Move-to-center (API v9)
    A holding servo can silently lose torque when the next servo's inrush
    current dips the supply (reset -> torque off) — the observed 'joint
    collapses after its test' failure. Between test phases a watchdog now reads
    back TORQUE_ENABLE of every held servo, re-parks and re-enables it on loss,
    and logs a clear warning pointing at the PSU current limit.
    The single 'Move to center' button now also honors the hold-center checkbox
    (hold pose for demos; unchecked = mounting mode with torque released);
    release via the release-torque button as usual.
    [server.py, servo_bus.py]
2026-07-26 Hold diagnostics v10: live-stream held joints, drift detection
    Max observed supply current of ~0.3 A rules out a brown-out; to pinpoint
    the remaining cause the watchdog now also detects 'torque ON but drifted
    off center' (weak hold / lost goal) separately from 'torque bit dropped',
    and held joints are read during other joints' moves so their live angle
    streams to the GUI — the moment a hold slips is visible in the 3D model.
    [server.py]
2026-07-26 Log UX: copy button, stick-to-bottom only at bottom, 300-line ring
2026-07-26 Teach-in demos: named motion sequences stored in demos/ (API v11)
    Pose the 3D model with the joint sliders and capture steps ('+ add step');
    each step stores target angles (CAD frame) for the configured joints plus
    per-step speed, accel and an optional pause. Demos are saved as one JSON
    per file under demos/ and listed in the GUI for playback.
    Playback moves each step's joints simultaneously, clamps every target to
    the configured joint limits (logged), applies mount offsets, skips servos
    not present on the bus, streams all positions live (3D model plays along),
    and holds the final pose — release via release-torque, Stop stays E-stop.
    Includes demos/example_wave.json and format docs.
    [server.py]
2026-07-26 Physical teach-in: capture steps from the real robot's pose (API v12)
    '+ step (robot pose)' reads the hand-posed robot (torque released) via
    GET /api/robot_pose — offset-aware, missing servos reported — and stores
    it as a demo step, mirroring the pose onto the 3D model. Step rows now
    show a summary (n joints != 0 / 'center pose') so all-zero steps are
    obvious at a glance.
    [server.py]
2026-07-26 Demo editor: clear steps on delete; wrap step rows so pose/remove buttons stay visible
2026-07-26 Demo dropdown: '— new demo —' entry resets the step editor
2026-07-26 Model zero pose matches the real robot; cautious walk demo (API v13)
    The CAD scene pose (bent knees, one raised arm) is not the robot's
    calibrated zero. Display-only per-joint corrections, computed from the
    CAD joint geometry (straighten legs, hang arms), now map the 3D model's
    rest pose onto the real standing pose — stored in
    hardware/model_zero_offsets.json, fine-tunable per joint in the GUI
    ('model zero' button folds the current pose slider into the correction).
    Servo angles are unaffected.
    demos/careful_walk.json: very cautious forward shuffle without a balance
    policy — tiny weight shifts (hip_roll +/-6), minimal foot lift (max 14
    deg), slow speeds (<=300), settling pauses; sign con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
    [server.py]
2026-07-26 Load-sag compensation for demo/center moves; exact-center teach step (API v14)
    Observed on hardware: taught poses deviated under load (robot leaned back
    when standing up from a squat) and 'center by hand' captures were ~10 deg
    off, so the kneeing demo never ended at true center.
    - Settle pass in _move_all_and_wait (demo steps, centering, hold parks):
    measure the steady-state residual after the move and over-command by it,
    clamped to the joint limits, max 2 trim iterations; logs 'load sag
    compensated' / 'residual pose error'. Range sweeps stay raw.
    - New '+ center' teach button appends an exact all-zero step; kneeing demo
    got one appended as its final step.
    - User manual: pose-accura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
    [server.py]
2026-07-26 Recalibrate model zero pose visually against the real robot
    The geometry-derived corrections overshot (joint-origin lines are offset
    from the limb axes): legs tipped far backward. Recalibrated by iterating
    headless renders against photos of the robot's true zero pose: hips -/+12,
    ankles -/+12, right_shoulder_pitch +63.3 (the CAD scene's raised arm —
    correct in the original estimate). Model now rests upright with straight
    legs, flat feet and both arms hanging; per-joint fine-tuning remains
    available via the 'model zero' button.
2026-07-26 Calibrate model zero from a fully posed model (API v15)
    Manual whole-body calibration: pose any number of joints with the sliders
    until the model matches the real robot's zero pose, then one click folds
    every posed angle into the display corrections (bulk endpoint; sliders
    reset, pose stays). Merges with existing corrections; zero removes.
    [server.py]
2026-07-26 Move calibrate-all model-zero button out of the hidden pose row
2026-07-26 Model direction invert (knees) + ground-contact display (API v16)
    - Per-joint display inversion for joints whose real servo turns opposite
    to the rig (hardware/model_invert.json, toggle button per joint; both
    knee pitches seeded). Display only — servo commands unaffected.
    - Ground-contact heuristic ('gravity feel', checkbox, default on): each
    frame the model is shifted vertically so the lowest foot rests on the
    floor plane — kneeling lowers the body instead of pushing feet through
    the ground. No physics: feet may slide horizontally.
    [server.py]
2026-07-26 Model display: invert hip pitch pair (like the knees)
2026-07-26 Ground contact: align the stance foot's sole flush with the floor
    Beyond the vertical snap, the model is now tilted (damped, anchored at the
    stance foot's contact point) so the stance sole's plane lies flat on the
    ground — maximum contact area instead of a single corner touching. Sole
    normals are captured at the calibrated rest pose; stance foot = lower foot
    with 5 mm hysteresis. Still display-only: no tipping, feet may slide.
2026-07-27 Whole body assembled: new hero GIF, status update, GUI capability docs
    - Hero: whole-body demo (kneeling, standing up, waving) with the Web GUI's
    CAD model mirroring the motion live; 3x time-lapse from media/raw footage
    - Build log/roadmap: Phase 1 done, Phase 2 assembly done (whole body on the
    bus, calibrated); RL locomotion remains
    - Software section: current Web GUI capabilities (bring-up & calibration,
    safety net, group/demo runs, teach-in, grounded visualization)
    - Snapshot of the current calibration state (limits, offsets, model zero,
    servo map) and taught demos (wave; example_wave removed)
    [servo_map.json]
2026-07-27 Refresh GUI media with the calibrated model
    Old captures still showed the raw CAD scene pose (raised arm, bent knees).
    New set: calibrated standing model, a selected hip joint with gauge/ID/
    limits from the configs, and a demo GIF of the taught-in kneeling sequence
    in simulation — ground-contact display and live log (limit clamping,
    load-sag compensation) visible.
2026-07-30 M0: promote the verification suites into the repo as a pytest regression net
    Nine bring-up suites (hold-center, watchdog, settle, demos, zero/offsets,
    model-zero, presence, robot-pose, fixes) now live in tests/suites/, each
    executed in a fresh interpreter by tests/test_suites.py — the gate for the
    shared-core refactor. 9/9 green on the current state.
2026-07-30 M1a: extract the serial bus layer into the shared zbot_core package
    servo_bus.py moves to zbot_core/bus.py (git mv, history preserved) and
    gains an explicit Bus protocol plus an open_bus() factory (explicit port,
    auto-detect, or SimBus mock). servo_gui depends on zbot-core as an
    editable path dependency; behavior unchanged — regression net 9/9 green.
2026-07-30 M1b: move config I/O into zbot_core.ConfigStore (root-configurable)
    All calibration/motion configs (servo IDs, limits, offsets, model zero/
    invert, demos incl. the Demo/DemoStep models and slug logic) are read and
    written through a ConfigStore bound to a root directory — repo checkout on
    the laptop, synced copy on the Pi later. Atomic writes centralized.
    server.py keeps thin delegates; suites patch server.CFG instead of path
    globals. Regression net 9/9 green; server boots against the real repo
    (3 demos, 16 limits, 16 IDs served).
    [config.py, server.py]
2026-07-30 M1c: extract the motion engine into zbot_core.MotionEngine
    The run lifecycle (atomic slot claim, threads, E-stop semantics), all
    bodies (single sweep/center, group sweeps with hold-center and watchdog,
    demo playback with limit clamping, offsets and settle passes) and the live
    State move into zbot_core/motion.py as a MotionEngine bound to a Bus and a
    ConfigStore. Engine raises typed MotionError instead of HTTPException;
    server.py shrinks from 1329 to 730 lines and becomes the HTTP adapter
    (endpoints, SSE, connection, bus utilities, static files). Log strings —
    part of the observable contract — are unchanged. Regression net 9/9 green,
    headless browser smoke (kneeing demo in simulation) cle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
2026-07-30 M1 review fixes: demo log parity, remove refactor debris
    Adversarial review of the M1 diff confirmed two defects: (1) demo playback
    routed through the shared launcher gained the 'no limits configured'
    warning the pre-refactor demo path never logged — warn_unlimited=False
    restores log parity (verified: demo silent, group runs still warn);
    (2) the field body of the old local CenterParams class survived as
    unreachable dead code inside the /api/test handler — removed, along with
    the now-unused re import. Regression net 9/9 green.
    [motion.py, server.py]
2026-07-31 Fix corrupt left_hip_pitch limits; guard against zero-excluding bands
    Hardware regression found demos slamming left_hip_pitch to the seam: its
    limits had drifted to [+90, +176.4] (signature of a re-zero shifting the
    limits, followed by a manual offset edit that didn't shift them back).
    The demo clamp then pulled taught ~0 deg poses UP to the +90 minimum.
    Restored the last approved band [-90, +45].
    Engine guard: build_plan now refuses to start any group/demo run when a
    joint's limit band excludes its own zero position (or min > max) with a
    message pointing at the calibration — this exact corruption gets caught
    loudly instead of moving hardware. Verified: wave commands the shoulder,
    hip sta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
    [motion.py]
2026-07-31 M2: connection config (hardware/connection.json)
    Mode (usb|wireless), serial port and Pi URL live in one config, served
    via ConfigStore with defaults merged. /api/connect resolves the port from
    it: explicit UI choice wins, a pinned value ('COM4', '/dev/serial/by-id/
    ...') is used otherwise, 'auto' keeps single-adapter auto-detection.
    /api/status exposes the merged connection config (the GUI mode switch
    will read it in M4). New regression suite covers pin/override/merge;
    net 10/10 green.
    [config.py, server.py]
2026-07-31 M3: Pi intent service (FastAPI on zbot_core, SimBus-tested)
    Intent-only API per docs/robot-context.md: status/demos/demo/center/
    release/stop/connect/heartbeat. Safety stays Pi-local (limits, offsets,
    corrupt-calibration guard in MotionEngine); heartbeat watchdog scaffold
    (0.5 s -> soft hold) for future streaming clients; CORS open, auth-ready.
    Config root via ZBOT_ROOT, SimBus via ZBOT_SIMULATE. 12 TestClient tests.
2026-07-31 M3: one-command Pi deploy (script + systemd unit + bring-up guide)
    deploy_pi.ps1 stages core+service+calibration+demos (connection.json
    stays host-specific, never shipped), installs editable into ~/venv,
    refreshes the zbot-pi systemd unit and health-checks /status.
    docs/pi-service.md: API reference, first bring-up, troubleshooting
    (ProtonVPN LAN, by-id port pinning, journalctl).
2026-07-31 Fix: tolerate UTF-8 BOM in configs; malformed connection.json never bricks Pi startup
    First real deploy hit this: a PowerShell-piped connection.json carried a
    BOM, read_json (strict utf-8) raised at lifespan startup and systemd
    looped. read_json now uses utf-8-sig; the Pi service degrades a broken
    connection.json to a logged warning (+2 regression tests).
    [config.py, service.py]
2026-07-31 M4: wireless mode in the web GUI (USB/local <-> Wireless/Pi)
    Mode switch in the Connection section, persisted via POST /api/connection
    (hardware/connection.json). Wireless: browser is a pure client of the Pi
    intent service — demo list/play, STOP, center, release, live log/phase and
    3D rig pose via a ~2.5 Hz status poll; bench tooling hidden (usb-only/
    pi-only CSS). USB mode unchanged. API v17, Pi service v2.
    Adversarial review findings fixed (12-agent verify pass, 3 real):
    - mode switch mid-run would hide the working STOP: server refuses like
    /api/disconnect, radios disabled while running, handler reverts on error
    - refreshDemos cross-mode race: stale dead-Pi response could clobber the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
    [config.py, server.py, service.py]
2026-08-01 M5: wireless teach-in (capture, edit and save demos over Wi-Fi)
    Pi service v3: GET /robot_pose (CAD-frame deg, offsets applied, busy
    guard), POST /demos + /demos/delete — the robot keeps its own copy so
    play works without a redeploy; the repo copy stays canonical (GUI
    dual-writes laptop-then-Pi with a WARNING if the robot copy fails).
    GUI v18: teach-in visible in both modes; model posing (slider) works
    wireless; + robot pose reads through the Pi; bus/calibration tooling
    stays USB-only. Review fix: a failed Pi write no longer swaps the
    wireless demo picker to the repo list. Tests: 19 Pi + 10 GUI suites.
    [server.py, service.py]
2026-08-06 Vendor three.js 0.160.1 for a fully offline GUI; add robot context doc
    - Serve three.js + addons from static/vendor/ instead of the jsdelivr CDN,
    so the servo GUI works without internet access
    - docs/robot-context.md: distilled hardware/deployment ground truth from
    bring-up sessions (operating modes, Pi setup, safety rules)
    - README: document offline capability, point at renamed pinned CAD model
    - connection.json: default mode switched to wireless (Pi at pixel.local)
    - settings.json: accumulated permission allowlist entries
2026-08-21 M6: MuJoCo/ksim RL training stack — build-specific model + walking task
    Post-K-Scale-shutdown stack decision (ksim/MJX; fallback MuJoCo Playground,
    see sim/README.md). sim/tools/build_model.py generates the 16-DoF model from
    kscale-assets zbot-feet with this build's servo IDs, STS3250/STS3215 actuator
    split (sys-ID params), grippers removed and the upstream ±2 Nm clamps
    stripped. Vendored walking task (16 DoF) with the actuator-ordering fix and
    the xax JSON-logger shim. Verified end-to-end on GPU (PPO, checkpoint,
    TF export). Adds docs/sim-context.md (hardware ground truth for sim).
    [3215_1Flange.stl, 3215_1Flange_2.stl, 3215_BothFlange_10.stl, 3215_BothFlange_13.stl, 3215_BothFlange_14.stl, 3215_BothFlange_5.stl, 3215_BothFlange_6.stl, 3215_BothFlange_9.stl]
2026-08-21 Pi pixel2 bring-up: Linux deploy script + host migration to 192.168.178.147
    Fresh Pi (hostname pixel2) after the old one died; all pixel.local
    references migrated to the reserved IP (mDNS served a stale ghost entry,
    pixel2.fritz.box is IPv6-only while the service binds IPv4). New
    deploy_pi.sh mirrors deploy_pi.ps1 for Linux/macOS; both run the systemd
    step non-interactively via the scoped sudoers rule /etc/sudoers.d/zbot-deploy.
    Serial port pinned via /dev/serial/by-id on the Pi.
    [config.py]
2026-08-21 GUI+service: mode parity (lock/release), waypoint preview, idle twin, Pi shutdown
    One torque path for both modes (zbot_core release_joints/lock_joints; new
    POST /lock + /api/lock): per-servo selection and the new lock-at-current-
    position for multi-limb teach-in. Servo list visible in wireless mode.
    Waypoint preview in the demo editor (click a step -> model shows/edits that
    pose, detached from live; runs re-attach). Idle digital twin: delta-mirror
    of hand-moved joints with full sync on (re)connect — also filters the
    1-encoder-count flicker that the ground-contact heuristic amplified.
    POST /shutdown intent + GUI button with SD-card-safe confirmation banner
    (appears once the Pi is unreachabl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
2026-08-23 User Manual: how to start the web UI; update wireless feature table
    Proper 'Starting the web UI' subsection (any machine with the repo, uv
    prerequisite, USB vs wireless startup, port note). Wireless column updated
    for today's features (lock/release parity, waypoint preview, idle twin,
    shutdown); teach-in workflow now includes the lock step; Linux deploy
    script referenced alongside the ps1.
2026-08-23 Pi bring-up: document the rebuild path after the SD card death
    The 2026-08-23 failure took out the Pi's SD card mid-run: the card's
    controller lost its flash translation layer, so the kernel kept answering
    pings from RAM while every fork() from disk died — sshd never reached its
    banner and zbot-pi could not restart. Nothing was lost (demos, calibration
    and code are all in this repo), but the Pi-local setup had to be rebuilt
    from four documents that each assumed the others' output.
    New docs/pi-bringup.md covers blank card -> green /status end to end, and
    pi_setup.sh does the two root-only steps in one pass: journal capped at
    50M, and the scoped sudoers rule installed only after visudo -c a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
2026-08-23 GUI: body-region servo grouping, fix silently dropped demo pauses
    Pauses typed into a demo step never arrived: the step editor read fields
    with `+e.target.value`, and an <input type=number> reports value === ''
    as soon as the control rejects the typed text — a comma as the decimal
    separator being the obvious way in on a German keyboard. `+''` is 0, so
    every pause became "no pause" while the integer-only speed and accel
    fields kept working. The engine was fine; motion.py has always honoured
    pause_s. Pause is now a text field with inputmode=decimal, parsed through
    parseNum() which takes either separator, leaves the previous value alone
    on unparseable input instead of zeroing it, and marks th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
2026-08-23 demos: walk_0 teach-in (3 steps)
    Captured before the pause fix, so all three pause_s are 0 — they need
    re-entering now that the field works.
2026-09-05 GUI: calibrate joint ranges over Wi-Fi; one selection for model and list
    Joint limits were a USB-mode feature, and that quietly cost a taught pose:
    the robot enforces its OWN copy of joint_limits.json, so widening a range in
    the repo never reached it and every demo kept clamping against the last
    deployed values. The Pi service now serves GET/POST /limits, and the GUI
    writes both copies exactly the way taught-in demos already work — the repo
    stays canonical and git-tracked, the robot gets the copy it actually clamps
    against, effective on its next run without a redeploy. In wireless mode the
    GUI reads the robot's values back, because those are the ones that apply,
    and logs a warning when rep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
2026-09-05 Shoulder pitch widened to ±95°, push_ups demo, roadmap: Pi locked out
    The shoulders were limited to ±60°, which clamped the push_ups teach-in by
    ~28° per side (log: left_shoulder_pitch +92.5 -> +60.0, right -91.9 ->
    -60.0). Re-measured against the mechanical stops: the ranges now run from
    the zero pose out to ±95°, so zero sits on the end stop and the arm no
    longer travels past it the other way. That is deliberate for this motion and
    still passes the engine's corrupt-limits guard, which only requires the band
    to contain zero — worth re-checking if a later demo needs the arm behind the
    torso.
    These values are NOT on the robot yet, and cannot be put there right now:
    its authorized_ke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
2026-09-05 Pi: keep dev SSH keys in the repo + offline installer for a locked-out robot
    The robot's authorized_keys held exactly one key, on one laptop, and when
    that laptop was reset the robot became unreachable for deploys. Nothing
    remote gets it back — sshd is publickey-only by design, the intent service
    exposes no file-write primitive (demo saves are slug-restricted to
    demos/*.json), and the serial console belongs to the servo UART. That is the
    right posture for a machine on the LAN; it just needs a documented way back
    in that does not depend on which laptop still exists.
    hardware/dev_authorized_keys now lists every dev machine's PUBLIC key, so
    access can be restored from any checkout. authorize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
2026-09-22 Roadmap: re-flashing the Pi's SD card on the laptop is the top priority
    The SSH lockout from 2026-09-05 is still open, and the recovery path the
    roadmap described does not fit the hardware at hand: the only card reader
    is in the Windows 11 laptop, and Windows cannot write the ext4 rootfs where
    authorized_keys lives — authorize_dev_keys.sh needs Linux. So the card
    gets re-flashed with Raspberry Pi Imager, which writes the keys itself.
    docs/pi-bringup.md gains a runbook for exactly that, step by step from the
    laptop: give the reset laptop a new key and add it to dev_authorized_keys
    before flashing (with only the workstation line on the card, the laptop
    would stay locked out), rescue robot-o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
2026-09-22 Backpack CAD (v2 → v4.2) + Attachments panel in the servo GUI
    hardware/backpack_v2/ holds the CadQuery models of the replacement
    electronics backpack (fuse path, XY-CD63 low-voltage cutoff, buzzer,
    separate Pololu buck, LiPo in the backpack), mounted 1:1 on the torso's
    existing backpack interface: v2 (two layers, fallback), v3.1 (single
    layer, Pi on a carrier inside the torso) and v4.x (Pi back in the
    backpack — the torso only has 57 mm between its ribs for a 56 mm board).
    check_cables.py models every cable as a tube with its minimum bend radius
    and checks it against parts and the arm/leg sweep envelopes; print/ has
    the current support-free print files and notes (PRINT.md).
    viewer/expor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
    [backpack_v2_base.stl, backpack_v2_base_robotframe.stl, backpack_v2_deck.stl, backpack_v2_deck_robotframe.stl, backpack_v2_lid.stl, backpack_v2_lid_robotframe.stl, backpack_v3_base.stl, backpack_v3_base_robotframe.stl]
2026-09-22 Head sensors: IMU in the left eye, Camera Module 3 in the right
    head_imu/: Waveshare RP2040-LCD-1.28 (round display + QMI8658 6-axis IMU)
    in the left eye. The two header sockets now sit on two webs fixed to the
    back plate instead of loose printed adapters (state 2026-09-19); board
    model, mounting pose (imu_pose.json) and clearance checks included.
    head_cam/: the MilkV camera in the right eye is replaced by a Raspberry
    Pi Camera Module 3 (standard lens, 75°). Only the head shell changes; the
    neck mount stays as it is. Includes the rebuilt shell as a print file, the
    camera/cable/field-of-view models in the assembly frame for the GUI, and
    cam3_pose.json.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
    [cam3_board.stl, cam3_fov.stl, cam3_fpc.stl, cam3_j1.stl, cam3_module.stl, head_shell_cam3.stl, imu_adapter.step, imu_adapter.stl]
2026-09-22 Sim: zbot-cad model of the built robot, walking task + eval tooling
    The zbot-pixel models came from the upstream K-Scale Z-Bot 2 assets — a
    different robot (gripper hands, other leg chain). sim/tools/
    build_model_cad.py now builds sim/assets/zbot-cad/ from the pinned OnShape
    CAD the servo GUI shows: fastened mates merge into links, revolute mates
    become joints, electronics this build lacks are dropped, and the GUI's
    zero offsets/axis inversions are applied so sim joint angle == servo
    angle. add_backpack.py derives zbot-pixel-backpack with a mass model of
    the printed backpack.
    walking.py gains the reward terms and switches used for the runs in
    sim/README.md (foot slip, single support, swin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
    [3215_1Flange.stl, 3215_1Flange_2.stl, 3215_BothFlange_10.stl, 3215_BothFlange_13.stl, 3215_BothFlange_14.stl, 3215_BothFlange_5.stl, 3215_BothFlange_6.stl, 3215_BothFlange_9.stl]
2026-09-22 Backpack CAD v4.3–v4.6 + head back plate counterbores
    Backpack (hardware/backpack_v2, CadQuery):
    - v4.3: Pi shifted so the inserted microSD card has 6.5 mm to the side wall,
    microSD window in the side wall (45° roof, support-free)
    - v4.4: Pi rotated 180° in plane — SD edge at +X (window in the +X wall),
    USB-C edge at the bottom with 40 mm for a straight power plug, Ethernet/
    USB-A towards -X with a 50 mm plug zone; the only layout that keeps the
    torso screw domes free (documented placement search); Pololu moved to the
    lower left, cables and camera ribbon rerouted and re-checked
    - v4.5: lid — XY-CD63 hole spacing 58 → 56.5 mm, Waveshare boss bores Ø2.2,
    Ø5.5 × 3 mm re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
    [backpack_v3_base.stl, backpack_v3_base_robotframe.stl, backpack_v3_lid.stl, backpack_v3_lid_robotframe.stl, fuse_leg_2.stl, lipo_xt60_lead.stl, neck_mount_imu.stl, out_to_pololu.stl]
2026-09-22 Servo GUI + Pi service: center pose override, demo editor, power limits, flight recorder, head display
    zbot_core / both backends:
    - center pose override (hardware/center_pose.json): every "center" action —
    single servo, group, Pi, hold re-parks — targets it; center steps in demos
    ("center": true, or all angles 0) resolve to it at playback
    - demo steps: optional title (shown in the playback phase), play only up to a
    step (`until`), transit steps (pause 0) skip the load-sag settle pass
    - power limits (hardware/motion_limits.json, default speed 300 / acc 30):
    one clamp for every commanded move, logged once per run; staggered group
    starts (40 ms) so 16 inrush currents do not add up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
    [bus.py, config.py, gc9a01.py, head.py, main.py, motion.py, qmi8658.py, server.py]
2026-09-26 Sim: datasheet masses, stitched mesh volumes, real head-IMU pose
    The zbot-cad model still carried the v3.1 backpack two weeks after the CAD moved
    to v4.2 (base 155.6 vs 188.7 cm3; Pi, cutoff, Waveshare and warner had all moved),
    and it loaded an insert STL that the v4 script no longer writes. Masses were
    guesses throughout. Both are fixed, and the IMU now sits where the real one does.
    Masses, per component with a source and a V/D/S confidence tag:
    * hardware/electronics_masses.json -> sim/tools/build_mass_model.py ->
    hardware/mass_model.json places every non-printed gram where the CAD puts it:
    backpack parts on their v4.2 placeholder boxes, cables by centreline length
    (14 AWG silicone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
    [backpack_base.stl, backpack_insert.stl, backpack_lid.stl, base_printed.stl, robot.mjcf]
2026-09-26 Sim: unattended training queue, checkpoint picker, all five variants retrained
    All five walking recipes retrained on the corrected model (cad2_*). Every one
    walks 0/16 falls; torso roll still plateaus at ~25 deg, so the 5.7 cm sole is the
    limit rather than the mass distribution. The old cad_* policies observed a
    torso-mounted body-axis IMU and the old masses -- they are not transferable and
    the README now says so.
    sim/tools/train_queue.sh runs the variants sequentially on one GPU as a systemd
    user unit, resolving each fine-tune's parent checkpoint through pick_best.py.
    Sweeps are CPU-only and run in the background so the GPU never idles; a fine-tune
    waits only for its own parent's sweep.
    T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
    [pick_best.py]
2026-09-26 Sim-to-sim prep: engine-independent Feetech model, correct IMU frame in exports
    export_policy.py hard-coded "IMU frame = body frame (x fwd, y left, z up)" into
    policy_meta.json. Since the model rebuild that is wrong: the site carries the real
    chip axes of the head IMU. A deployment trusting that line would feed rotated axes
    to the policy -- the most expensive sim-to-real mistake available here. The
    description is now derived from the model's own metadata, and the whole imu block
    (position, quaternion, R_body_from_imu) travels with the export.
    sim/tools/feetech_numpy.py is a NumPy port of the actuator model ksim trains with,
    so another engine can drive the joints identically. A plain PD posi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
    [check_feetech_port.py, export_policy.py, feetech_numpy.py]
2026-09-26 README: untethered push-ups hero, head sensors, sim-to-real roadmap
    Replaces the hero GIF with the push-ups demo: the robot runs it off the
    3S LiPo and the Pi in the backpack, no bench PSU and no USB cable.
    Documents what the clip actually shows and what the README never
    mentioned: the animated eye on the round LCD in the left eye socket,
    driven by the QMI8658 behind it, and the Camera Module 3 in the right
    one whose MJPEG stream is the window on the laptop in the background.
    Brings the rest in line with the build:
    - backpack from "CAD" to built, wired and carrying the electronics
    - Phase 2 closed, Phase 3 is sim-to-real
    - simulation section rewritten: the model comes from the built robot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
2026-10-01 Sim: version the five retrained walking policies
    The policies were days of GPU time living only on this machine and in
    ~/zbot-ckpt-backup. They are now in the repo under sim/policies/, one directory
    per variant with what is actually needed:
    policy.onnx the network for the robot (64 -> 16, 288 k parameters)
    policy_meta.json the deployment contract: input layout in order, joint order,
    servo ids, actuator types, IMU axes, action semantics
    ckpt.bin to resume, fine-tune or re-export
    eval.txt the measurements of that checkpoint
    ~7 MB per policy, 37 MB total. Deliberately left out: videos, rollout data and the
    xax SavedModels -- they are m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
