Justin-Riekehof/zeroth-01-build/(notices)

Notices in the files:
README.md:
License: MIT
